opensimgear/device-template/hardware/README.md

# Mechanical hardware

## Development status and disclaimer

This project is heavily under development and is not ready for use. Use it entirely at your own risk. To the fullest extent permitted by applicable law, the authors and contributors disclaim all liability for any damage, loss, or other issues arising from its use.

No mechanical CAD or manufacturing-ready assembly is provided. Lite and Pro are reserved directories within this device repository. Mechanical implementation is tracked in the [GitHub project](https://github.com/orgs/opensimgear/projects/2).
