opensimgear/device-template/electronics/boards/starter/0.1.0/home-milling/review/wire-joins.csv

x_mm | y_mm | net | hole_mm | copper_land_mm | assembly
86.0 | 81.0 | GND | 0.8 | 1.8 | solder wire to both faces before bodies block access
89.2 | 92.0 | +3V3 | 0.8 | 1.8 | solder wire to both faces before bodies block access
91.0 | 97.54 | A0_RAW | 0.8 | 1.8 | solder wire to both faces before bodies block access
91.0 | 107.54 | A1_RAW | 0.8 | 1.8 | solder wire to both faces before bodies block access
91.0 | 117.54 | A2_RAW | 0.8 | 1.8 | solder wire to both faces before bodies block access
91.0 | 127.54 | A3_RAW | 0.8 | 1.8 | solder wire to both faces before bodies block access
91.0 | 137.54 | A4_RAW | 0.8 | 1.8 | solder wire to both faces before bodies block access
91.0 | 147.54 | A5_RAW | 0.8 | 1.8 | solder wire to both faces before bodies block access
91.0 | 157.54 | A6_RAW | 0.8 | 1.8 | solder wire to both faces before bodies block access
91.0 | 167.54 | A7_RAW | 0.8 | 1.8 | solder wire to both faces before bodies block access
97.9019 | 94.7684 | GND | 0.8 | 1.8 | solder wire to both faces before bodies block access
97.9019 | 104.7684 | GND | 0.8 | 1.8 | solder wire to both faces before bodies block access
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
