opensimgear/device-template/electronics/boards/starter/0.1.0/home-milling/coupon/review/back.png

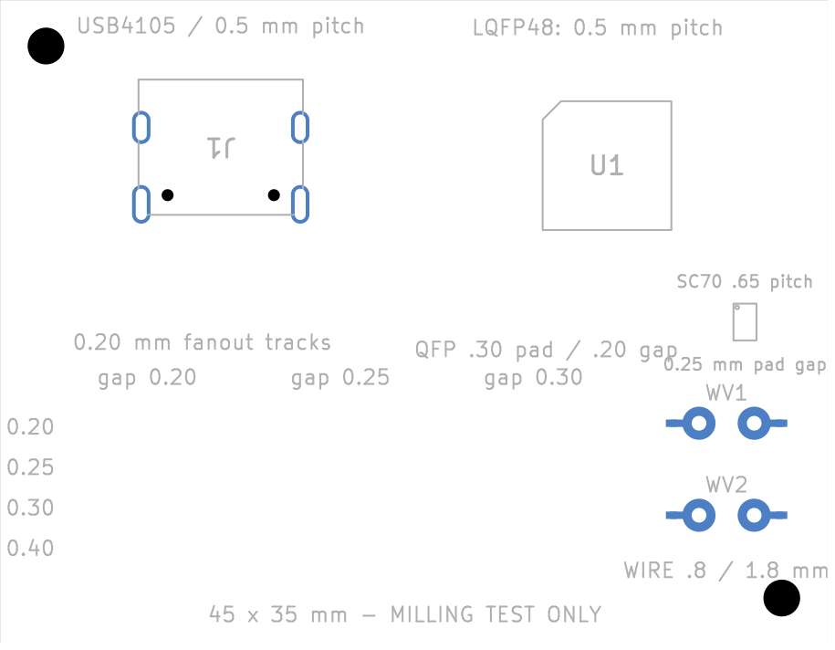
electronics/boards/starter/0.1.0/home-milling/coupon/review/back.png
