opensimgear/device-template/electronics/boards/starter/0.1.0/home-milling/coupon/review/front.png

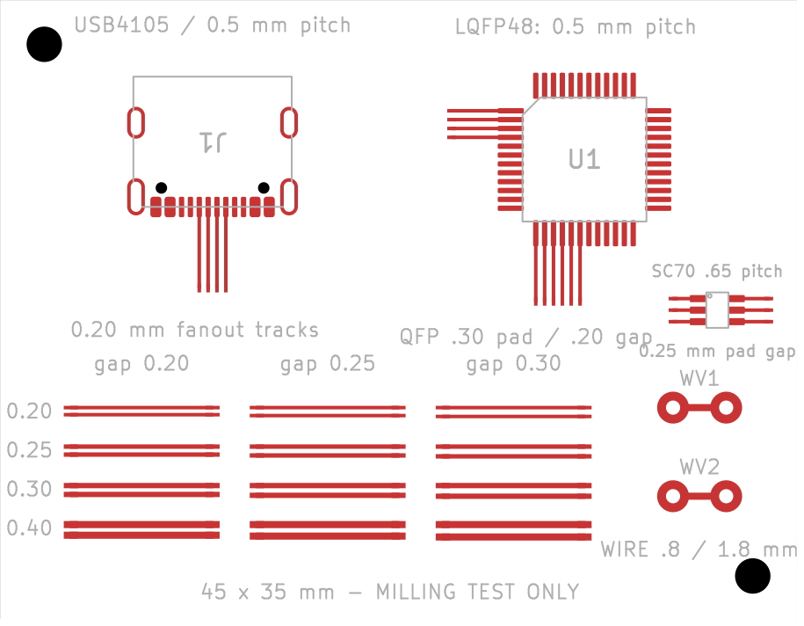
electronics/boards/starter/0.1.0/home-milling/coupon/review/front.png
