opensimgear/device-template/electronics/boards/starter/0.1.0/home-milling/review/back.png

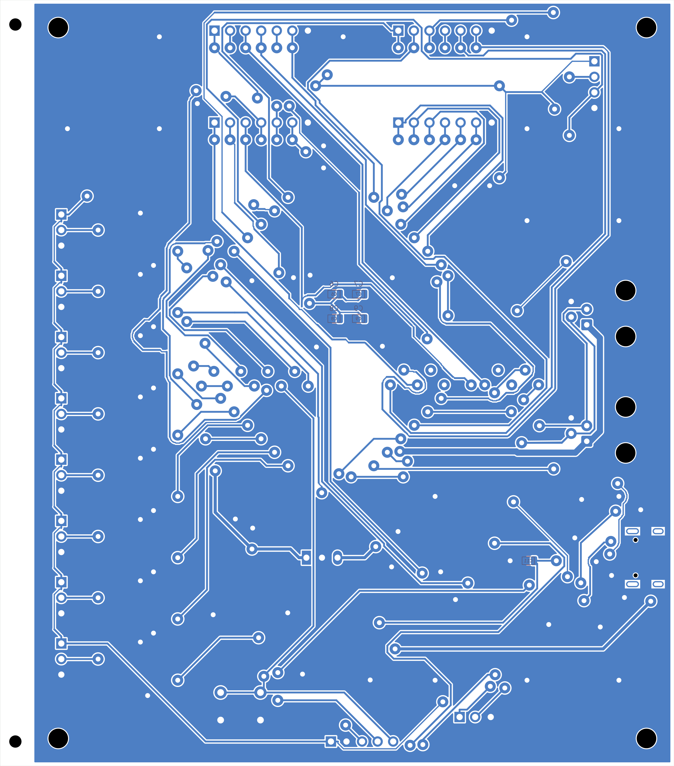
electronics/boards/starter/0.1.0/home-milling/review/back.png
