opensimgear/device-template/electronics/boards/starter/0.1.0/home-milling/review/front.png

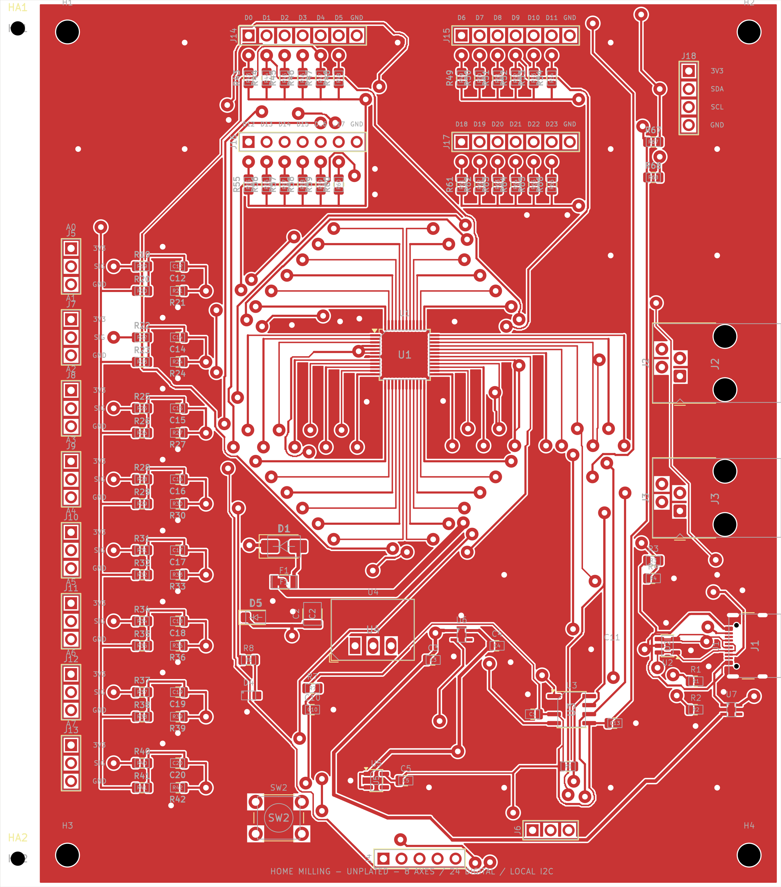
electronics/boards/starter/0.1.0/home-milling/review/front.png
