opensimgear/device-template/electronics/boards/starter/0.1.0/bom.csv

Reference | Value | Manufacturer part | Footprint | Datasheet
U1 | STM32G0B1CBT6 | STM32G0B1CBT6 | KiCad:LQFP-48_7x7mm_P0.5mm | https://www.st.com/resource/en/datasheet/stm32g0b1cb.pdf
J1 | USB-C DEVICE | USB4105-GF-A | KiCad:USB_C_Receptacle_GCT_USB4105-xx-A_16P_TopMnt_Horizontal | https://gct.co/files/drawings/usb4105.pdf
U2 | USBLC6-2SC6 | USBLC6-2SC6 | KiCad:SOT-23-6 | https://www.st.com/resource/en/datasheet/usblc6-2.pdf
R1 | 5.1k 1% | RC0805FR-075K1L | KiCad:R_0805_2012Metric | https://www.yageogroup.com/component-documentation/download/specsheet/RC0805FR-075K1L
R2 | 5.1k 1% | RC0805FR-075K1L | KiCad:R_0805_2012Metric | https://www.yageogroup.com/component-documentation/download/specsheet/RC0805FR-075K1L
R3 | 10k 1% | RC0805FR-0710KL | KiCad:R_0805_2012Metric | https://www.yageogroup.com/component-documentation/download/specsheet/RC0805FR-0710KL
R4 | 15k 1% | RC0805FR-0715KL | KiCad:R_0805_2012Metric | https://www.yageogroup.com/component-documentation/download/specsheet/RC0805FR-0715KL
U3 | TCAN3413D | TCAN3413D | KiCad:SOIC-8_3.9x4.9mm_P1.27mm | https://www.ti.com/lit/ds/symlink/tcan3413.pdf
J2 | 4P4C POWERED CAN | 5301-4P4C | OpenSimGear:RJ4P4C_Evercom_5301-4P4C_Horizontal | https://jlcpcb.com/partdetail/EVERCOM-53014P4C/C3097715
J3 | 4P4C POWERED CAN | 5301-4P4C | OpenSimGear:RJ4P4C_Evercom_5301-4P4C_Horizontal | https://jlcpcb.com/partdetail/EVERCOM-53014P4C/C3097715
R5 | 10k | RC0805FR-0710KL | KiCad:R_0805_2012Metric | https://www.yageogroup.com/component-documentation/download/specsheet/RC0805FR-0710KL
C1 | 100nF 25V X7R | C0805C104K3RACTU | KiCad:C_0805_2012Metric | https://content.kemet.com/datasheets/KEM_C1002_X7R_SMD.pdf
J6 | CAN TEST / END TERMINATION | TSW-103-07-L-S | OpenSimGear:PinHeader_Samtec_TSW-103-07-L-S_P2.54mm_Vertical | https://suddendocs.samtec.com/prints/tsw-xxx-xx-x-x-xx-xxx-footprint.pdf
F1 | 0.25A hold / 24V | 1206L025/24YR | OpenSimGear:Fuse_Littelfuse_1206L025-24YR | https://www.littelfuse.com/assetdocs/resettable-ptcs-1206l-datasheet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
D1 | SS14 | SS14-E3/61T | KiCad:D_SMA | https://www.vishay.com/docs/88746/ss12.pdf
U4 | R-78E5.0-0.5 | R-78E5.0-0.5 | KiCad:Converter_DCDC_RECOM_R-78E-0.5_THT | https://recom-power.com/pdf/Innoline/R-78E-0.5.pdf
U5 | TLV75533PDBVR | TLV75533PDBVR | KiCad:SOT-23-5 | https://www.ti.com/lit/ds/symlink/tlv755p.pdf
C2 | 10uF 50V X7R | GRM32ER71H106KA12L | KiCad:C_1210_3225Metric | https://search.murata.co.jp/Ceramy/image/img/A01X/G101/ENG/GRM32ER71H106KA12-04A.pdf
C3 | 1uF 25V X7R | C2012X7R1E105K125AB | KiCad:C_0805_2012Metric | https://product.tdk.com/en/search/capacitor/ceramic/mlcc/info?part_no=C2012X7R1E105K125AB
C4 | 1uF 25V X7R | C2012X7R1E105K125AB | KiCad:C_0805_2012Metric | https://product.tdk.com/en/search/capacitor/ceramic/mlcc/info?part_no=C2012X7R1E105K125AB
C5 | 2.2uF 25V X7R | C2012X7R1E225K125AB | KiCad:C_0805_2012Metric | https://product.tdk.com/en/search/capacitor/ceramic/mlcc/info?part_no=C2012X7R1E225K125AB
C6 | 100nF 25V X7R | C0805C104K3RACTU | KiCad:C_0805_2012Metric | https://content.kemet.com/datasheets/KEM_C1002_X7R_SMD.pdf
C7 | 1uF 25V X7R | C2012X7R1E105K125AB | KiCad:C_0805_2012Metric | https://product.tdk.com/en/search/capacitor/ceramic/mlcc/info?part_no=C2012X7R1E105K125AB
C8 | 100nF 25V X7R | C0805C104K3RACTU | KiCad:C_0805_2012Metric | https://content.kemet.com/datasheets/KEM_C1002_X7R_SMD.pdf
C9 | 100nF 25V X7R | C0805C104K3RACTU | KiCad:C_0805_2012Metric | https://content.kemet.com/datasheets/KEM_C1002_X7R_SMD.pdf
J4 | SWD / 3V3 REFERENCE ONLY | TSW-105-07-L-S | OpenSimGear:PinHeader_Samtec_TSW-105-07-L-S_P2.54mm_Vertical | https://suddendocs.samtec.com/prints/tsw-xxx-xx-x-x-xx-xxx-footprint.pdf
SW2 | RESET | B3F-1002-G | KiCad:SW_PUSH_6mm_H4.3mm | https://omronfs.omron.com/en_US/ecb/products/pdf/en-b3f.pdf
R7 | 10k | RC0805FR-0710KL | KiCad:R_0805_2012Metric | https://www.yageogroup.com/component-documentation/download/specsheet/RC0805FR-0710KL
C10 | 100nF 25V X7R | C0805C104K3RACTU | KiCad:C_0805_2012Metric | https://content.kemet.com/datasheets/KEM_C1002_X7R_SMD.pdf
R8 | 1k | RC0805FR-071KL | KiCad:R_0805_2012Metric | https://www.yageogroup.com/component-documentation/download/specsheet/RC0805FR-071KL
D4 | GREEN | AP2012SGC | OpenSimGear:LED_Kingbright_AP2012SGC_0805 | https://www.kingbrightusa.com/images/catalog/SPEC/AP2012SGC.pdf
C11 | 100nF 25V X7R | C0805C104K3RACTU | KiCad:C_0805_2012Metric | https://content.kemet.com/datasheets/KEM_C1002_X7R_SMD.pdf
U6 | LM66100DCKR | LM66100DCKR | OpenSimGear:TI_DCK0006A_SC70-6_LM66100 | https://www.ti.com/lit/ds/symlink/lm66100.pdf
U7 | LM66100DCKR | LM66100DCKR | OpenSimGear:TI_DCK0006A_SC70-6_LM66100 | https://www.ti.com/lit/ds/symlink/lm66100.pdf
D5 | SMF15A-E3-08 | SMF15A-E3-08 | KiCad:D_SMF | https://www.vishay.com/docs/85881/smf5v0atosmf58a.pdf
C13 | 100nF 25V X7R | C0805C104K3RACTU | KiCad:C_0805_2012Metric | https://content.kemet.com/datasheets/KEM_C1002_X7R_SMD.pdf
J5 | AXIS A0 / 3.3V | TSW-103-07-L-S | OpenSimGear:PinHeader_Samtec_TSW-103-07-L-S_P2.54mm_Vertical | https://suddendocs.samtec.com/prints/tsw-xxx-xx-x-x-xx-xxx-footprint.pdf
R19 | 1k | RC0805FR-071KL | KiCad:R_0805_2012Metric | https://www.yageogroup.com/component-documentation/download/specsheet/RC0805FR-071KL
R20 | 1M | RC0805FR-071ML | KiCad:R_0805_2012Metric | https://www.yageogroup.com/component-documentation/download/specsheet/RC0805FR-071ML
R21 | 1M | RC0805FR-071ML | KiCad:R_0805_2012Metric | https://www.yageogroup.com/component-documentation/download/specsheet/RC0805FR-071ML
C12 | 100nF 25V X7R | C0805C104K3RACTU | KiCad:C_0805_2012Metric | https://content.kemet.com/datasheets/KEM_C1002_X7R_SMD.pdf
J7 | AXIS A1 / 3.3V | TSW-103-07-L-S | OpenSimGear:PinHeader_Samtec_TSW-103-07-L-S_P2.54mm_Vertical | https://suddendocs.samtec.com/prints/tsw-xxx-xx-x-x-xx-xxx-footprint.pdf
R22 | 1k | RC0805FR-071KL | KiCad:R_0805_2012Metric | https://www.yageogroup.com/component-documentation/download/specsheet/RC0805FR-071KL
R23 | 1M | RC0805FR-071ML | KiCad:R_0805_2012Metric | https://www.yageogroup.com/component-documentation/download/specsheet/RC0805FR-071ML
R24 | 1M | RC0805FR-071ML | KiCad:R_0805_2012Metric | https://www.yageogroup.com/component-documentation/download/specsheet/RC0805FR-071ML
C14 | 100nF 25V X7R | C0805C104K3RACTU | KiCad:C_0805_2012Metric | https://content.kemet.com/datasheets/KEM_C1002_X7R_SMD.pdf
J8 | AXIS A2 / 3.3V | TSW-103-07-L-S | OpenSimGear:PinHeader_Samtec_TSW-103-07-L-S_P2.54mm_Vertical | https://suddendocs.samtec.com/prints/tsw-xxx-xx-x-x-xx-xxx-footprint.pdf
R25 | 1k | RC0805FR-071KL | KiCad:R_0805_2012Metric | https://www.yageogroup.com/component-documentation/download/specsheet/RC0805FR-071KL
R26 | 1M | RC0805FR-071ML | KiCad:R_0805_2012Metric | https://www.yageogroup.com/component-documentation/download/specsheet/RC0805FR-071ML
R27 | 1M | RC0805FR-071ML | KiCad:R_0805_2012Metric | https://www.yageogroup.com/component-documentation/download/specsheet/RC0805FR-071ML
C15 | 100nF 25V X7R | C0805C104K3RACTU | KiCad:C_0805_2012Metric | https://content.kemet.com/datasheets/KEM_C1002_X7R_SMD.pdf
J9 | AXIS A3 / 3.3V | TSW-103-07-L-S | OpenSimGear:PinHeader_Samtec_TSW-103-07-L-S_P2.54mm_Vertical | https://suddendocs.samtec.com/prints/tsw-xxx-xx-x-x-xx-xxx-footprint.pdf
R28 | 1k | RC0805FR-071KL | KiCad:R_0805_2012Metric | https://www.yageogroup.com/component-documentation/download/specsheet/RC0805FR-071KL
R29 | 1M | RC0805FR-071ML | KiCad:R_0805_2012Metric | https://www.yageogroup.com/component-documentation/download/specsheet/RC0805FR-071ML
R30 | 1M | RC0805FR-071ML | KiCad:R_0805_2012Metric | https://www.yageogroup.com/component-documentation/download/specsheet/RC0805FR-071ML
C16 | 100nF 25V X7R | C0805C104K3RACTU | KiCad:C_0805_2012Metric | https://content.kemet.com/datasheets/KEM_C1002_X7R_SMD.pdf
J10 | AXIS A4 / 3.3V | TSW-103-07-L-S | OpenSimGear:PinHeader_Samtec_TSW-103-07-L-S_P2.54mm_Vertical | https://suddendocs.samtec.com/prints/tsw-xxx-xx-x-x-xx-xxx-footprint.pdf
R31 | 1k | RC0805FR-071KL | KiCad:R_0805_2012Metric | https://www.yageogroup.com/component-documentation/download/specsheet/RC0805FR-071KL
R32 | 1M | RC0805FR-071ML | KiCad:R_0805_2012Metric | https://www.yageogroup.com/component-documentation/download/specsheet/RC0805FR-071ML
R33 | 1M | RC0805FR-071ML | KiCad:R_0805_2012Metric | https://www.yageogroup.com/component-documentation/download/specsheet/RC0805FR-071ML
C17 | 100nF 25V X7R | C0805C104K3RACTU | KiCad:C_0805_2012Metric | https://content.kemet.com/datasheets/KEM_C1002_X7R_SMD.pdf
J11 | AXIS A5 / 3.3V | TSW-103-07-L-S | OpenSimGear:PinHeader_Samtec_TSW-103-07-L-S_P2.54mm_Vertical | https://suddendocs.samtec.com/prints/tsw-xxx-xx-x-x-xx-xxx-footprint.pdf
R34 | 1k | RC0805FR-071KL | KiCad:R_0805_2012Metric | https://www.yageogroup.com/component-documentation/download/specsheet/RC0805FR-071KL
R35 | 1M | RC0805FR-071ML | KiCad:R_0805_2012Metric | https://www.yageogroup.com/component-documentation/download/specsheet/RC0805FR-071ML
R36 | 1M | RC0805FR-071ML | KiCad:R_0805_2012Metric | https://www.yageogroup.com/component-documentation/download/specsheet/RC0805FR-071ML
C18 | 100nF 25V X7R | C0805C104K3RACTU | KiCad:C_0805_2012Metric | https://content.kemet.com/datasheets/KEM_C1002_X7R_SMD.pdf
J12 | AXIS A6 / 3.3V | TSW-103-07-L-S | OpenSimGear:PinHeader_Samtec_TSW-103-07-L-S_P2.54mm_Vertical | https://suddendocs.samtec.com/prints/tsw-xxx-xx-x-x-xx-xxx-footprint.pdf
R37 | 1k | RC0805FR-071KL | KiCad:R_0805_2012Metric | https://www.yageogroup.com/component-documentation/download/specsheet/RC0805FR-071KL
R38 | 1M | RC0805FR-071ML | KiCad:R_0805_2012Metric | https://www.yageogroup.com/component-documentation/download/specsheet/RC0805FR-071ML
R39 | 1M | RC0805FR-071ML | KiCad:R_0805_2012Metric | https://www.yageogroup.com/component-documentation/download/specsheet/RC0805FR-071ML
C19 | 100nF 25V X7R | C0805C104K3RACTU | KiCad:C_0805_2012Metric | https://content.kemet.com/datasheets/KEM_C1002_X7R_SMD.pdf
J13 | AXIS A7 / 3.3V | TSW-103-07-L-S | OpenSimGear:PinHeader_Samtec_TSW-103-07-L-S_P2.54mm_Vertical | https://suddendocs.samtec.com/prints/tsw-xxx-xx-x-x-xx-xxx-footprint.pdf
R40 | 1k | RC0805FR-071KL | KiCad:R_0805_2012Metric | https://www.yageogroup.com/component-documentation/download/specsheet/RC0805FR-071KL
R41 | 1M | RC0805FR-071ML | KiCad:R_0805_2012Metric | https://www.yageogroup.com/component-documentation/download/specsheet/RC0805FR-071ML
R42 | 1M | RC0805FR-071ML | KiCad:R_0805_2012Metric | https://www.yageogroup.com/component-documentation/download/specsheet/RC0805FR-071ML
C20 | 100nF 25V X7R | C0805C104K3RACTU | KiCad:C_0805_2012Metric | https://content.kemet.com/datasheets/KEM_C1002_X7R_SMD.pdf
J14 | DIGITAL D0–D5 | TSW-107-07-L-S | OpenSimGear:PinHeader_Samtec_TSW-107-07-L-S_P2.54mm_Vertical | https://suddendocs.samtec.com/prints/tsw-xxx-xx-x-x-xx-xxx-footprint.pdf
R43 | 10k | RC0805FR-0710KL | KiCad:R_0805_2012Metric | https://www.yageogroup.com/component-documentation/download/specsheet/RC0805FR-0710KL
R44 | 10k | RC0805FR-0710KL | KiCad:R_0805_2012Metric | https://www.yageogroup.com/component-documentation/download/specsheet/RC0805FR-0710KL
R45 | 10k | RC0805FR-0710KL | KiCad:R_0805_2012Metric | https://www.yageogroup.com/component-documentation/download/specsheet/RC0805FR-0710KL
R46 | 10k | RC0805FR-0710KL | KiCad:R_0805_2012Metric | https://www.yageogroup.com/component-documentation/download/specsheet/RC0805FR-0710KL
R47 | 10k | RC0805FR-0710KL | KiCad:R_0805_2012Metric | https://www.yageogroup.com/component-documentation/download/specsheet/RC0805FR-0710KL
R48 | 10k | RC0805FR-0710KL | KiCad:R_0805_2012Metric | https://www.yageogroup.com/component-documentation/download/specsheet/RC0805FR-0710KL
J15 | DIGITAL D6–D11 | TSW-107-07-L-S | OpenSimGear:PinHeader_Samtec_TSW-107-07-L-S_P2.54mm_Vertical | https://suddendocs.samtec.com/prints/tsw-xxx-xx-x-x-xx-xxx-footprint.pdf
R49 | 10k | RC0805FR-0710KL | KiCad:R_0805_2012Metric | https://www.yageogroup.com/component-documentation/download/specsheet/RC0805FR-0710KL
R50 | 10k | RC0805FR-0710KL | KiCad:R_0805_2012Metric | https://www.yageogroup.com/component-documentation/download/specsheet/RC0805FR-0710KL
R51 | 10k | RC0805FR-0710KL | KiCad:R_0805_2012Metric | https://www.yageogroup.com/component-documentation/download/specsheet/RC0805FR-0710KL
R52 | 10k | RC0805FR-0710KL | KiCad:R_0805_2012Metric | https://www.yageogroup.com/component-documentation/download/specsheet/RC0805FR-0710KL
R53 | 10k | RC0805FR-0710KL | KiCad:R_0805_2012Metric | https://www.yageogroup.com/component-documentation/download/specsheet/RC0805FR-0710KL
R54 | 10k | RC0805FR-0710KL | KiCad:R_0805_2012Metric | https://www.yageogroup.com/component-documentation/download/specsheet/RC0805FR-0710KL
J16 | DIGITAL D12–D17 | TSW-107-07-L-S | OpenSimGear:PinHeader_Samtec_TSW-107-07-L-S_P2.54mm_Vertical | https://suddendocs.samtec.com/prints/tsw-xxx-xx-x-x-xx-xxx-footprint.pdf
R55 | 10k | RC0805FR-0710KL | KiCad:R_0805_2012Metric | https://www.yageogroup.com/component-documentation/download/specsheet/RC0805FR-0710KL
R56 | 10k | RC0805FR-0710KL | KiCad:R_0805_2012Metric | https://www.yageogroup.com/component-documentation/download/specsheet/RC0805FR-0710KL
R57 | 10k | RC0805FR-0710KL | KiCad:R_0805_2012Metric | https://www.yageogroup.com/component-documentation/download/specsheet/RC0805FR-0710KL
R58 | 10k | RC0805FR-0710KL | KiCad:R_0805_2012Metric | https://www.yageogroup.com/component-documentation/download/specsheet/RC0805FR-0710KL
R59 | 10k | RC0805FR-0710KL | KiCad:R_0805_2012Metric | https://www.yageogroup.com/component-documentation/download/specsheet/RC0805FR-0710KL
R60 | 10k | RC0805FR-0710KL | KiCad:R_0805_2012Metric | https://www.yageogroup.com/component-documentation/download/specsheet/RC0805FR-0710KL
J17 | DIGITAL D18–D23 | TSW-107-07-L-S | OpenSimGear:PinHeader_Samtec_TSW-107-07-L-S_P2.54mm_Vertical | https://suddendocs.samtec.com/prints/tsw-xxx-xx-x-x-xx-xxx-footprint.pdf
R61 | 10k | RC0805FR-0710KL | KiCad:R_0805_2012Metric | https://www.yageogroup.com/component-documentation/download/specsheet/RC0805FR-0710KL
R62 | 10k | RC0805FR-0710KL | KiCad:R_0805_2012Metric | https://www.yageogroup.com/component-documentation/download/specsheet/RC0805FR-0710KL
R63 | 10k | RC0805FR-0710KL | KiCad:R_0805_2012Metric | https://www.yageogroup.com/component-documentation/download/specsheet/RC0805FR-0710KL
R64 | 10k | RC0805FR-0710KL | KiCad:R_0805_2012Metric | https://www.yageogroup.com/component-documentation/download/specsheet/RC0805FR-0710KL
R65 | 10k | RC0805FR-0710KL | KiCad:R_0805_2012Metric | https://www.yageogroup.com/component-documentation/download/specsheet/RC0805FR-0710KL
R66 | 10k | RC0805FR-0710KL | KiCad:R_0805_2012Metric | https://www.yageogroup.com/component-documentation/download/specsheet/RC0805FR-0710KL
J18 | LOCAL 3.3V I2C EXPANSION | TSW-104-07-L-S | OpenSimGear:PinHeader_Samtec_TSW-104-07-L-S_P2.54mm_Vertical | https://suddendocs.samtec.com/prints/tsw-xxx-xx-x-x-xx-xxx-footprint.pdf
R67 | 4.7k | RC0805FR-074K7L | KiCad:R_0805_2012Metric | https://www.yageogroup.com/component-documentation/download/specsheet/RC0805FR-074K7L
R68 | 4.7k | RC0805FR-074K7L | KiCad:R_0805_2012Metric | https://www.yageogroup.com/component-documentation/download/specsheet/RC0805FR-074K7L
