opensimgear/device-template/electronics/boards/starter/0.1.0/review/routing.pdf

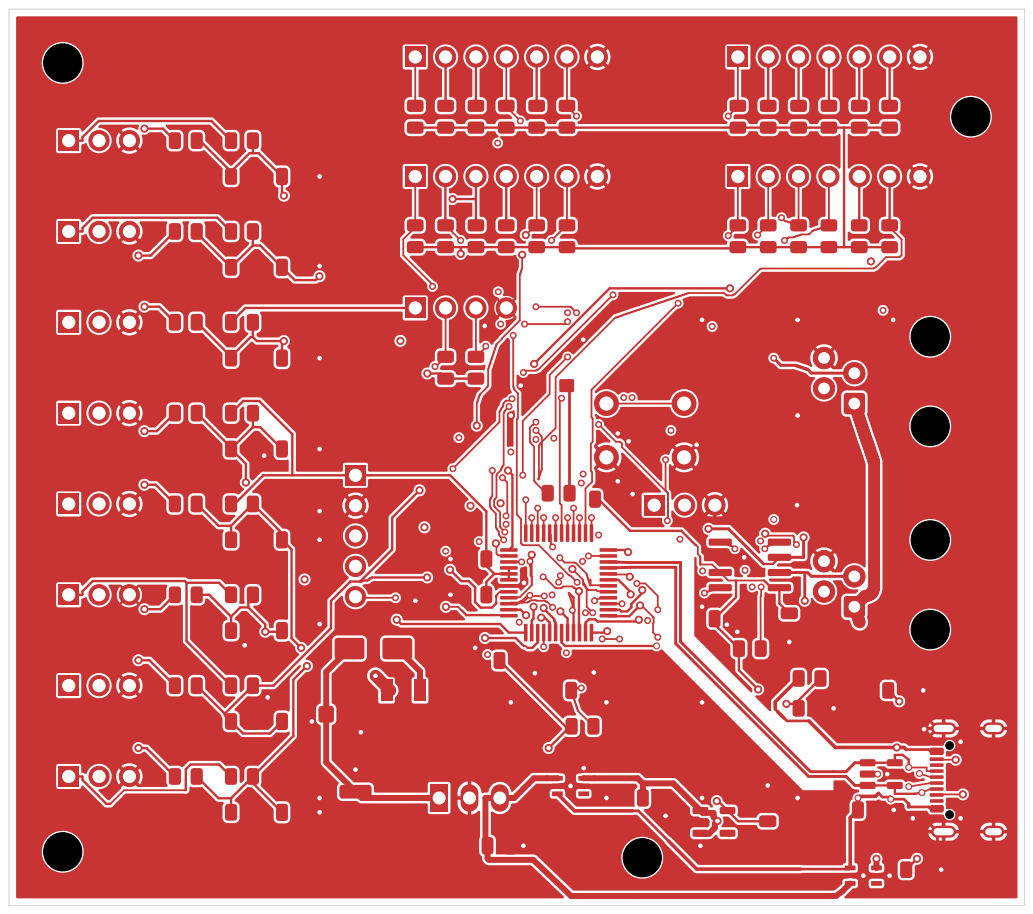
[picture p5: page 1]

OpenSimGear
Sheet:
File: starter.kicad_pcb
Title: OpenSimGear generic STM32G0B1 module

Size: A4 | Rev: 0.1.0
KiCad E.D.A. 10.0.6 | Id: 1/4

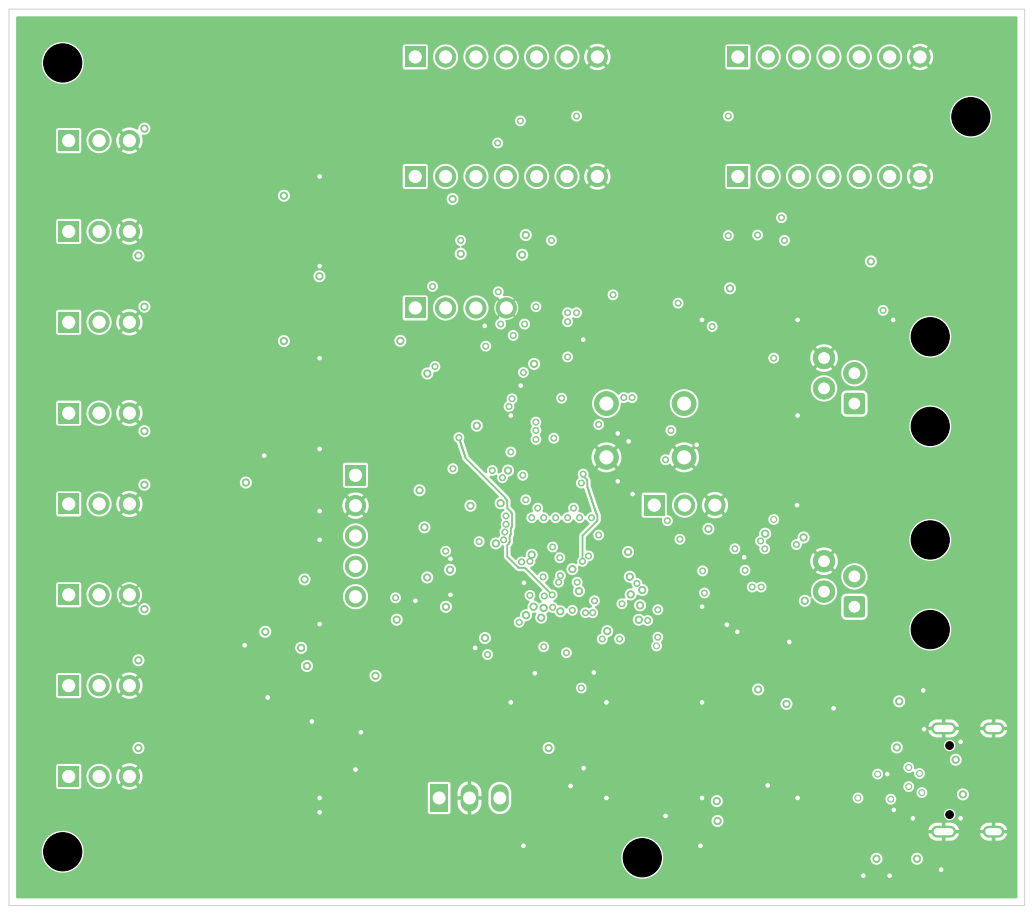
[picture p6: page 2]

OpenSimGear
Sheet:
File: starter.kicad_pcb
Title: OpenSimGear generic STM32G0B1 module

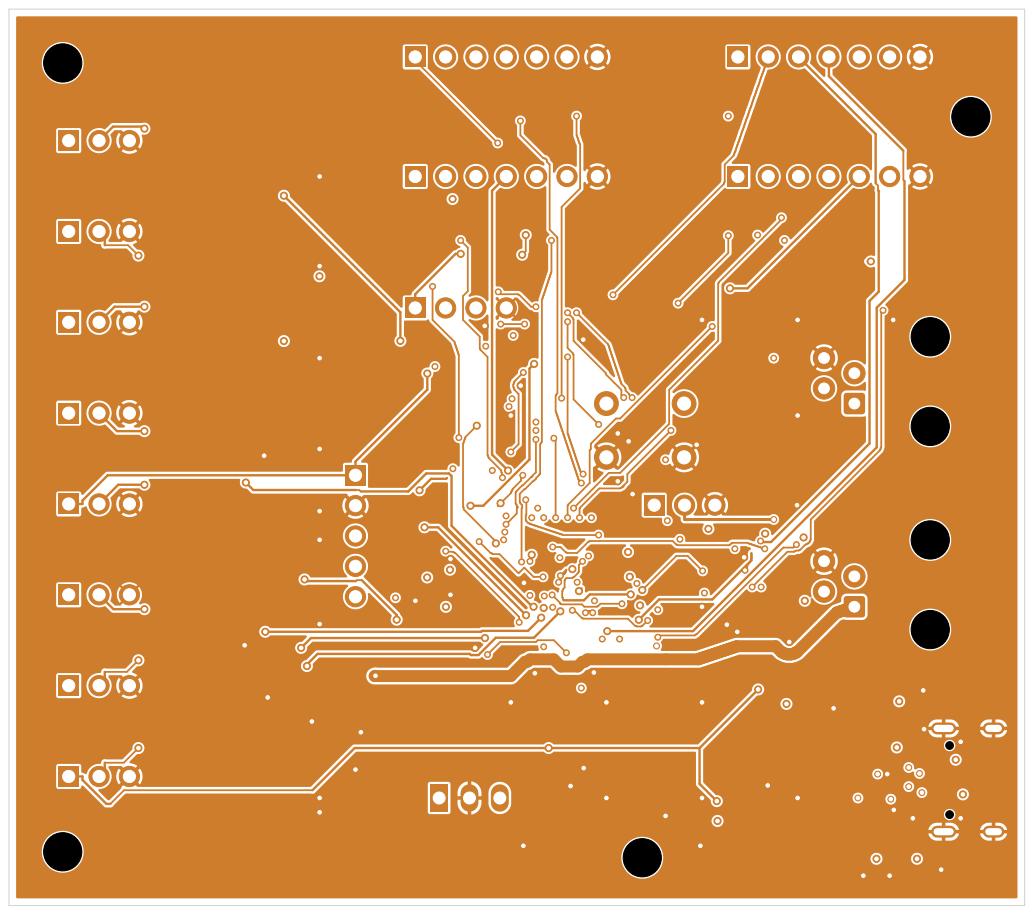
[picture p7: page 3]

OpenSimGear
Sheet:
File: starter.kicad_pcb
Title: OpenSimGear generic STM32G0B1 module

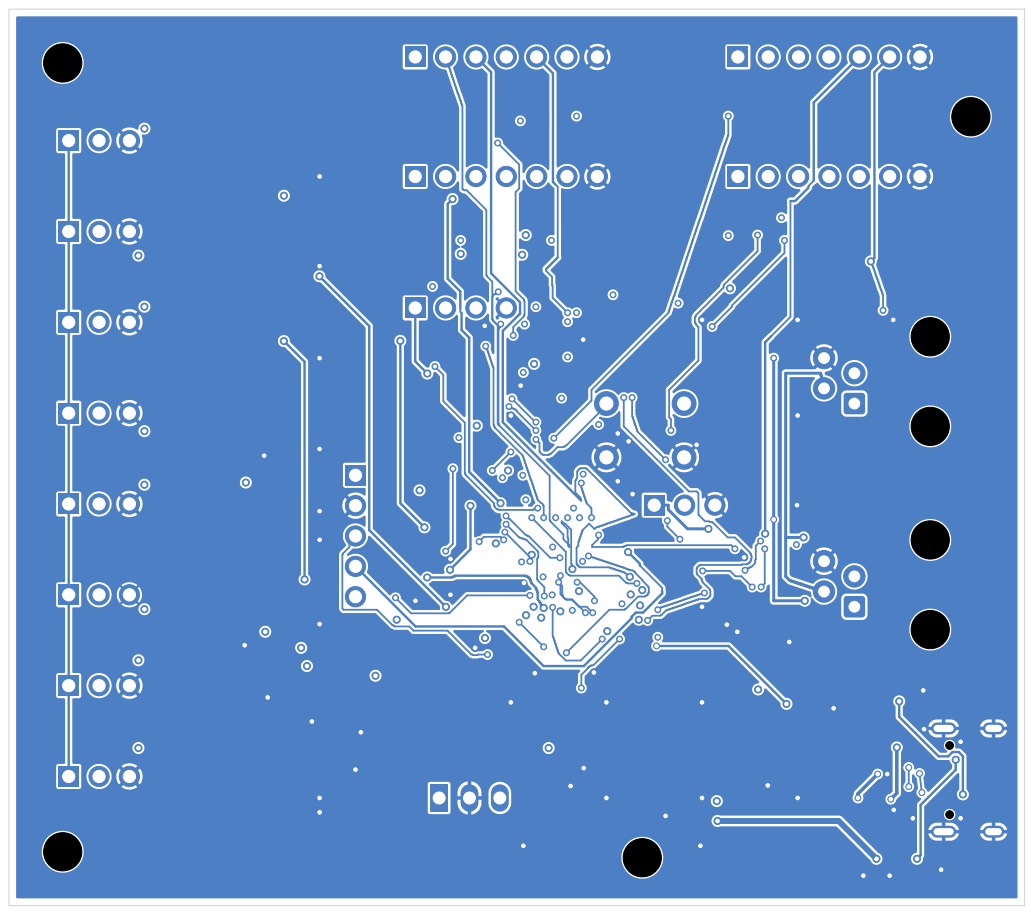
[picture p8: page 4]

OpenSimGear
Sheet:
File: starter.kicad_pcb
Title: OpenSimGear generic STM32G0B1 module
