opensimgear/device-template/electronics/boards/starter/0.1.0/review/schematic.pdf

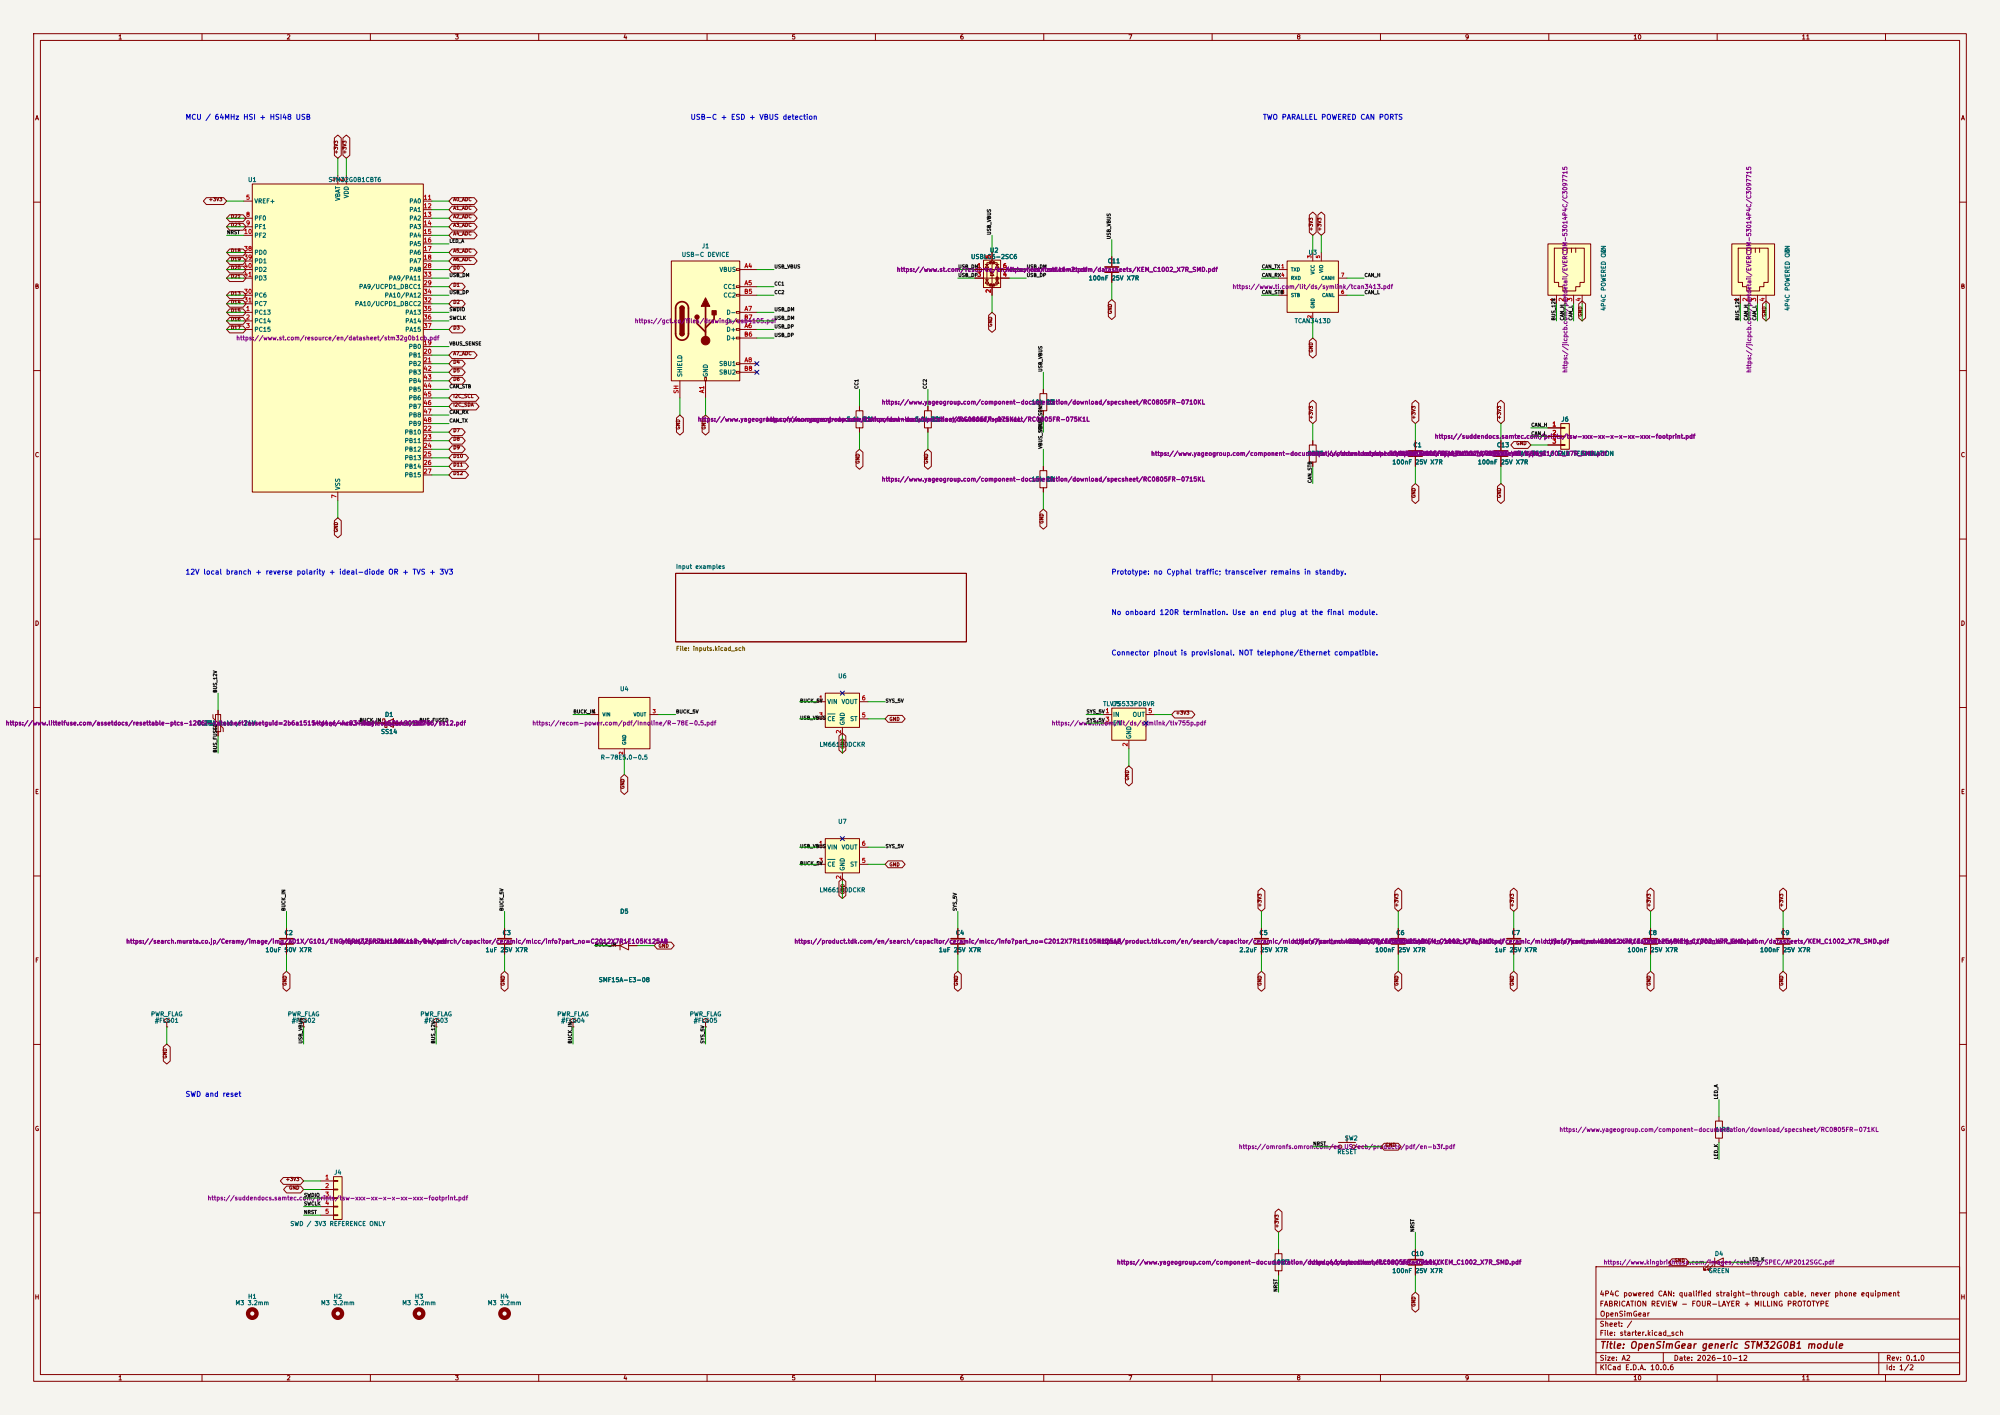
[picture p9: page 1]

USB-C + ESD + VBUS detection

4 J2 4P4C POWERED CAN https://jlcpcb.com/partdetail/EVERCOM-53014P4C/C3097715

4 J3 4P4C POWERED CAN https://jlcpcb.com/partdetail/EVERCOM-53014P4C/C3097715

https://content.kemet.com/datasheets/KEM_C1002_X7R_SMD.pdf

https://www.st.com/resource/en/datasheet/usblc6-2.pdf 1
https://www.st.com/resource/en/datasheet/usblc6-2.pdf

https://www.ti.com/lit/ds/symlink/tcan3413.pdf

https://gct.co/files/drawings/usb4105.pdf

https://suddendocs.samtec.com/prints/tsw-xxx-xx-x-x-xx-xxx-footprint.pdf GND A1

https://www.yageogroup.com/component-documentation/download/specsheet/RC0805FR-075K1L 5.1k R11%

https://www.yageogroup.com/component-documentation/download/specsheet/RC0805FR-075K1L 5.1k R21%

https://content.kemet.com/datasheets/KEM_C1002_X7R_SMD.pdf Local TCAN3413 VIO bypass 1

https://suddendocs.samtec.com/prints/tsw-xxx-xx-x-x-xx-xxx-footprint.pdf 1

J6 CAN TEST / END TERMINATION

https://www.yageogroup.com/component-documentation/download/specsheet/RC0805FR-0710KL 10kR5

https://content.kemet.com/datasheets/KEM_C1002_X7R_SMD.pdf Local TCAN3413 VCC bypass

https://content.kemet.com/datasheets/KEM_C1002_X7R_SMD.pdf Local TCAN3413 VIO bypass

Input examples File: inputs.kicad_sch

12V local branch + reverse polarity + ideal-diode OR + TVS + 3V3

Prototype: no Cyphal traffic; transceiver remains in standby.

No onboard 120R termination. Use an end plug at the final module.

Connector pinout is provisional. NOT telephone/Ethernet compatible.

https://www.vishay.com/docs/88746/ss12.pdf

https://recom-power.com/pdf/Innoline/R-78E-0.5.pdf

https://www.ti.com/lit/ds/symlink/tlv755p.pdf C4

https://search.murata.co.jp/Ceramy/image/img/A01X/G101/ENG/GRM32ER71H106KA12-04A.pdf

https://content.kemet.com/datasheets/KEM_C1002_X7R_SMD.pdf C6

https://content.kemet.com/datasheets/KEM_C1002_X7R_SMD.pdf C8

https://product.tdk.com/en/search/capacitor/ceramic/mlcc/info?part_no=C2012X7R1E105K125AB

https://product.tdk.com/en/search/capacitor/ceramic/mlcc/info?part_no=C2012X7R1E225K125AB

SW2 RESET https://omronfs.omron.com/en_US/ecb/products/pdf/en-b3f.pdf C10

https://www.yageogroup.com/component-documentation/download/specsheet/RC0805FR-071KL 1kR8

SWD / 3V3 REFERENCE ONLY https://suddendocs.samtec.com/prints/tsw-xxx-xx-x-x-xx-xxx-footprint.pdf H1 M3 3.2mm

https://www.yageogroup.com/component-documentation/download/specsheet/RC0805FR-0710KL 10kR7

https://www.kingbrightusa.com/images/catalog/SPEC/AP2012SGC.pdf

4P4C powered CAN: qualified straight-through cable, never phone equipment
FABRICATION REVIEW - FOUR-LAYER + MILLING PROTOTYPE
OpenSimGear
Sheet: /
File: starter.kicad_sch
Title: OpenSimGear generic STM32G0B1 module

Size: A2 | Rev: 0.1.0
KiCad E.D.A. 10.0.6 | Id: 1/2

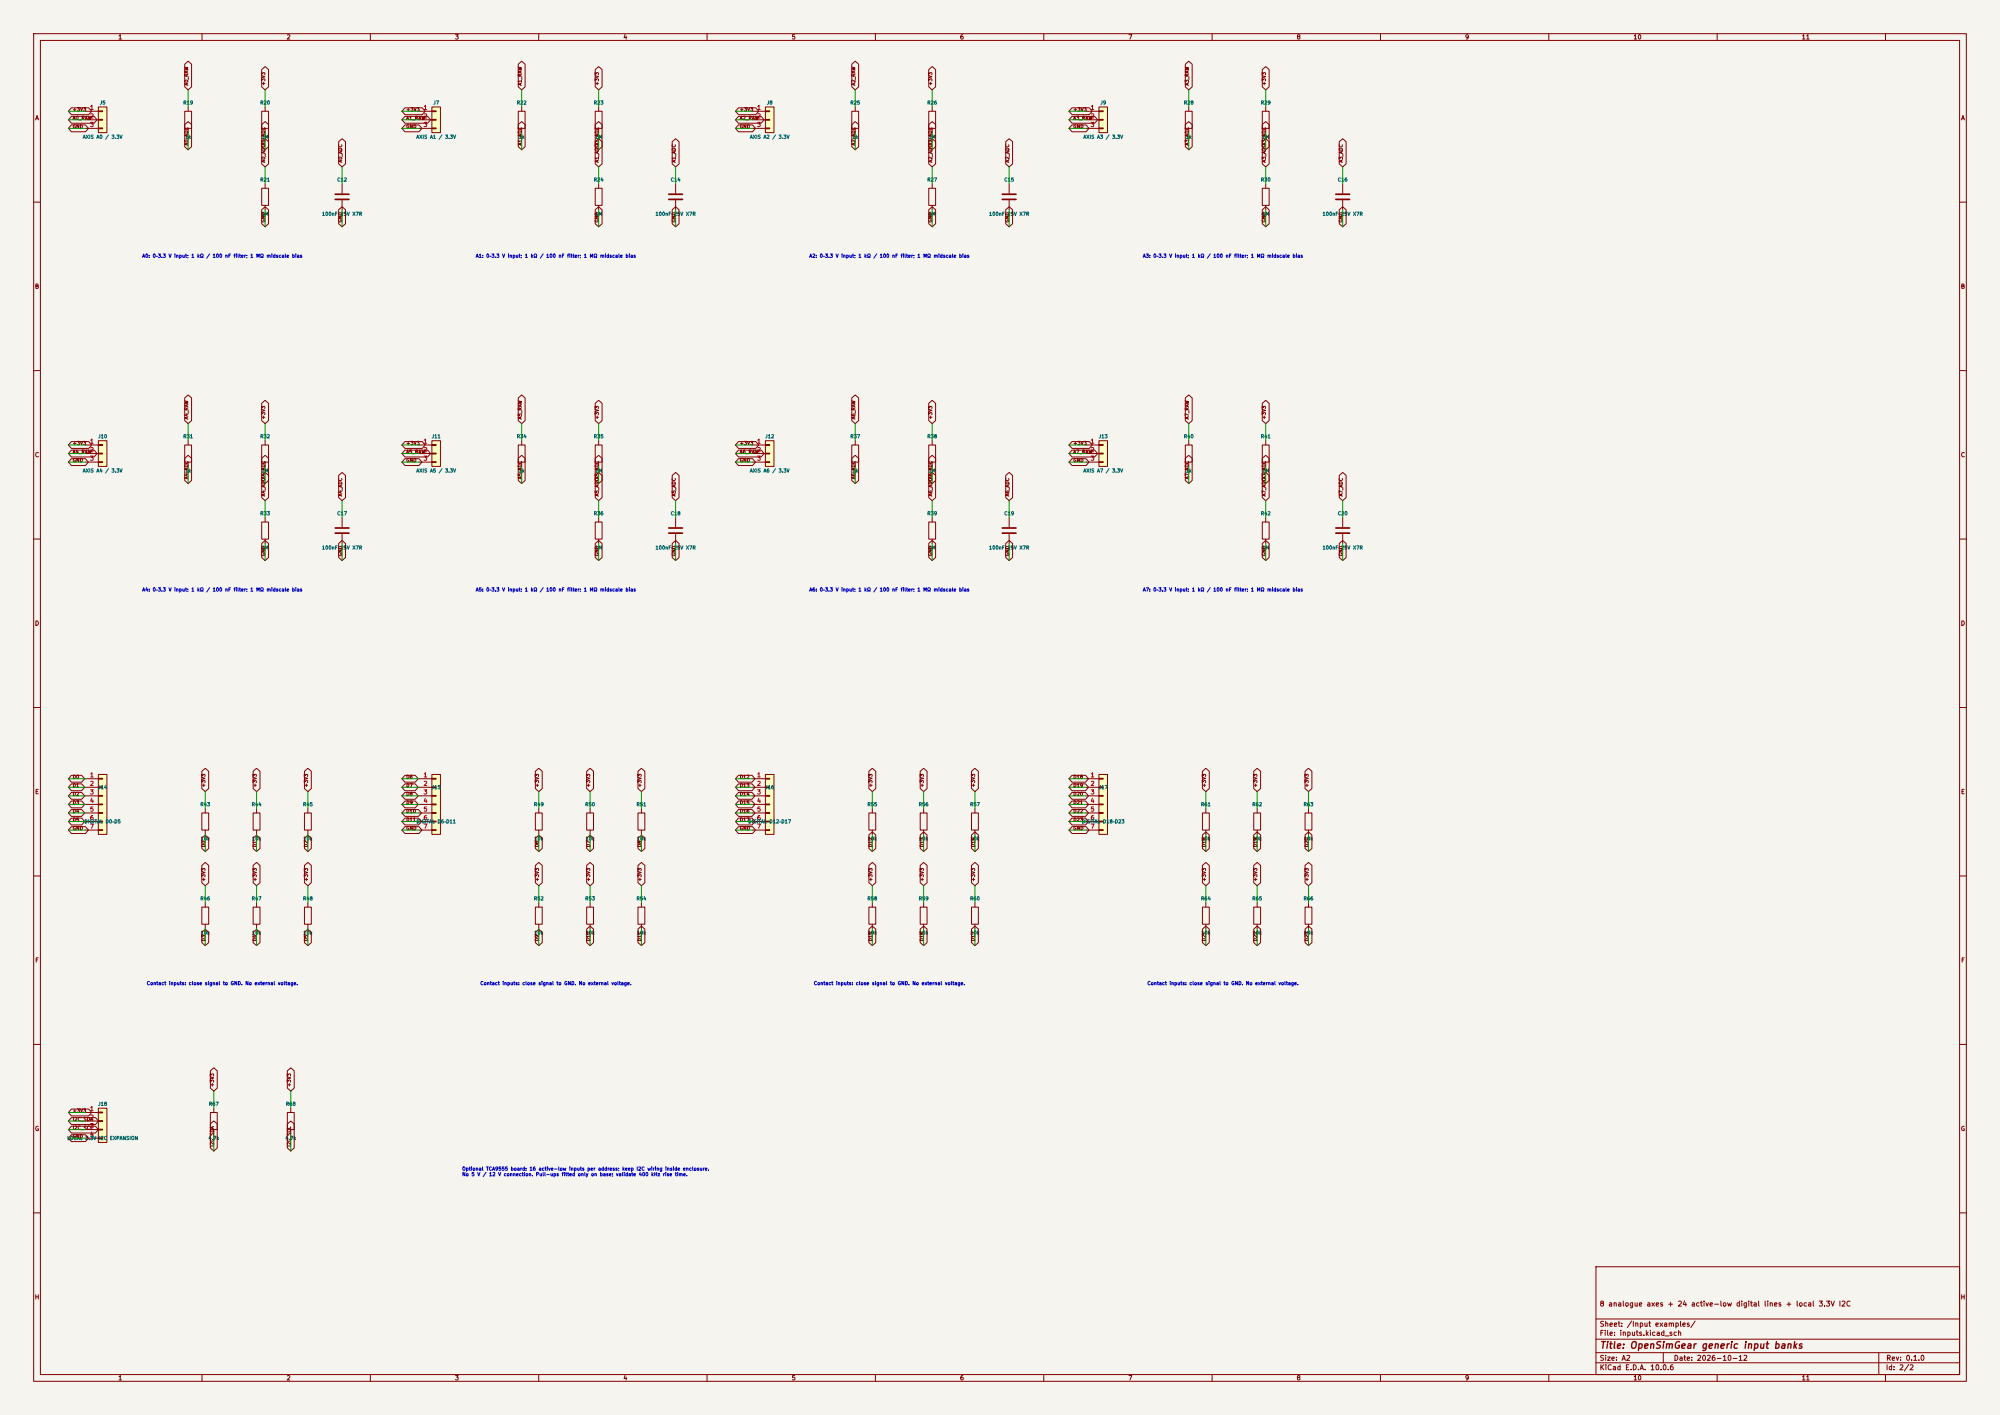
[picture p10: page 2]

A0: 0–3.3 V input; 1 kΩ / 100 nF filter; 1 MΩ midscale bias

A1: 0–3.3 V input; 1 kΩ / 100 nF filter; 1 MΩ midscale bias

A2: 0–3.3 V input; 1 kΩ / 100 nF filter; 1 MΩ midscale bias

A3: 0–3.3 V input; 1 kΩ / 100 nF filter; 1 MΩ midscale bias

A4: 0–3.3 V input; 1 kΩ / 100 nF filter; 1 MΩ midscale bias

A5: 0–3.3 V input; 1 kΩ / 100 nF filter; 1 MΩ midscale bias

A6: 0–3.3 V input; 1 kΩ / 100 nF filter; 1 MΩ midscale bias

A7: 0–3.3 V input; 1 kΩ / 100 nF filter; 1 MΩ midscale bias

Contact inputs: close signal to GND. No external voltage.

8 analogue axes + 24 active-low digital lines + local 3.3V I2C

Sheet: /Input examples/
File: inputs.kicad_sch
Title: OpenSimGear generic input banks

Size: A2 | Rev: 0.1.0
KiCad E.D.A. 10.0.6 | Id: 2/2
