opensimgear/device-template/electronics/boards/starter/0.1.0/home-milling/review/routing.pdf

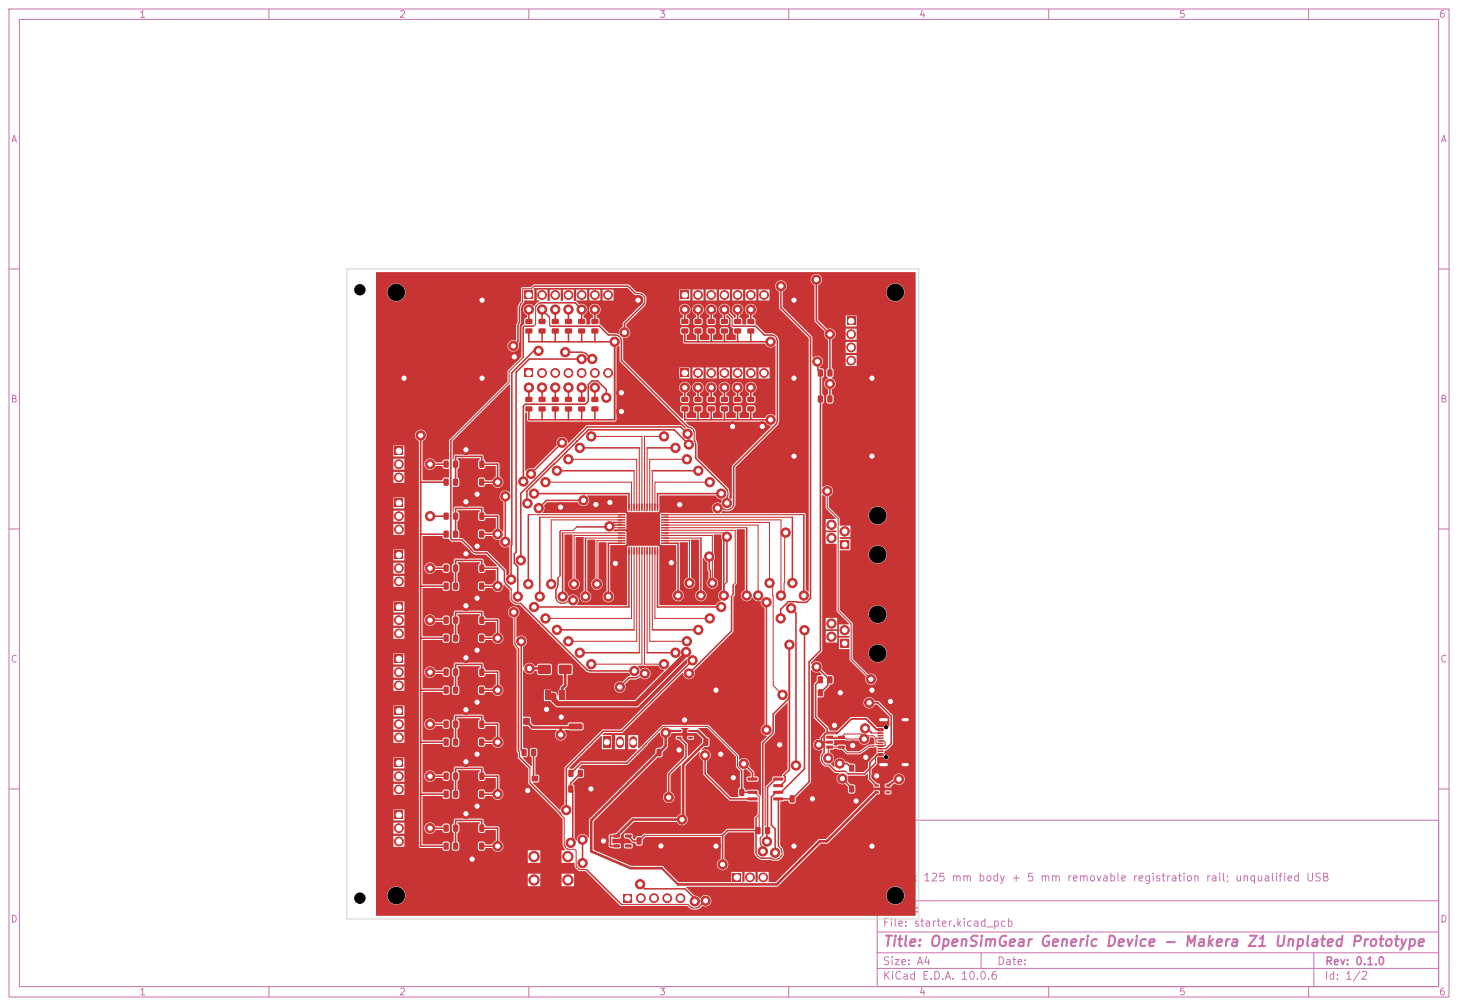
[picture p11: page 1]

105 x | 125 mm body + 5 mm removable registration rail; unqualified USB

Sheet: File: starter.kicad_pcb | | D Date:

Title: OpenSimGear Generic Device - Makera Z1 Unplated Prototype

Size: A4 | Rev: 0.1.0
KiCad E.D.A. 10.0.6 | Id: 1/2

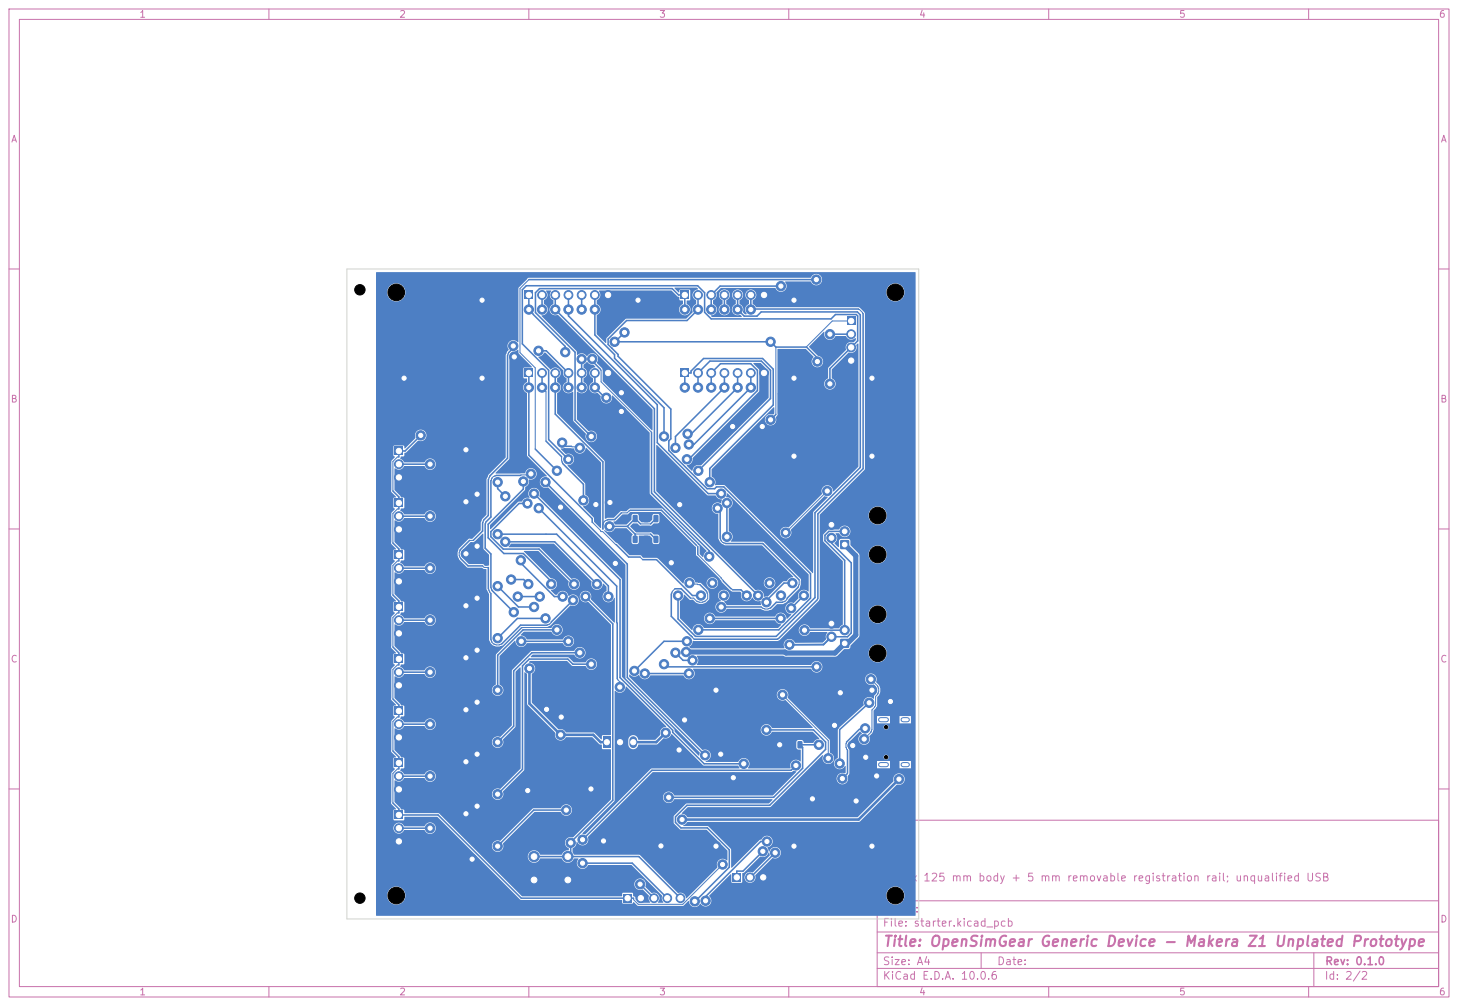
[picture p12: page 2]

105 x | 125 mm body + 5 mm removable registration rail; unqualified USB

Sheet: File: starter.kicad_pcb | | D Date:

Title: OpenSimGear Generic Device - Makera Z1 Unplated Prototype

Size: A4 | Rev: 0.1.0
KiCad E.D.A. 10.0.6 | Id: 2/2
