opensimgear/device-template/electronics/boards/starter/0.1.0/home-milling/coupon/review/coupon.pdf

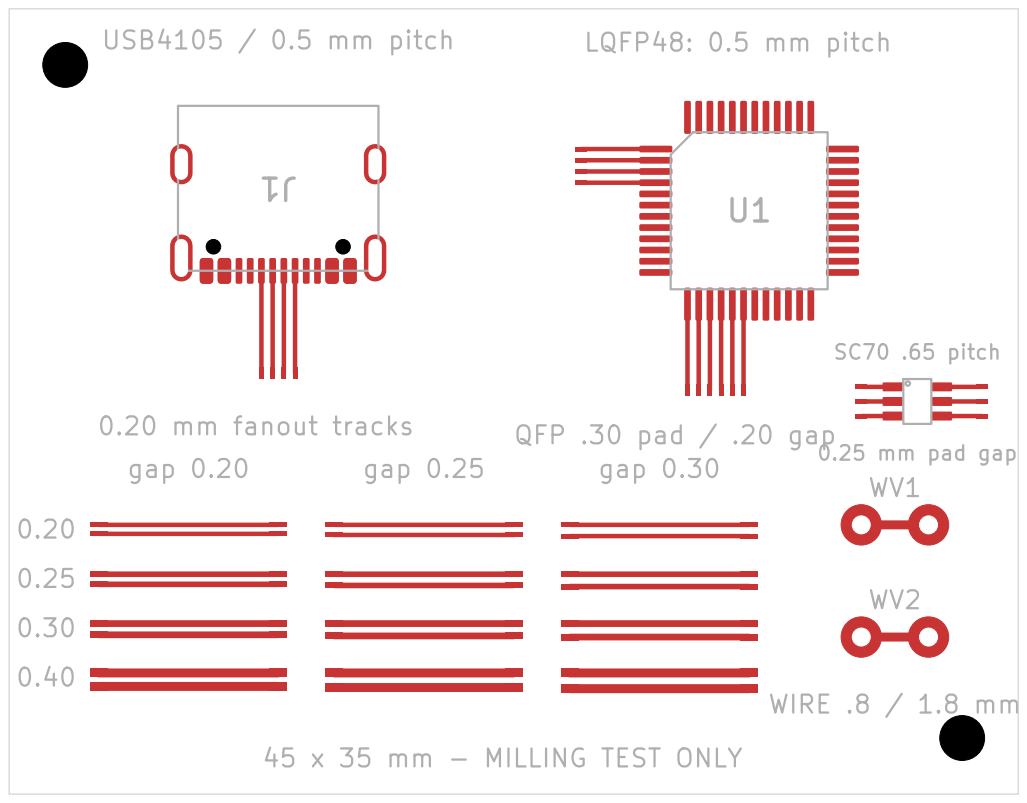
[picture p13: page 1]

0.20 mm fanout tracks USB4105 / 0.5 mm pitch

SC70 .65 pitch 0.25 mm pad gap 0.20

45 x 35 mm - MILLING TEST ONLY gap 0.30 QFP .30 pad / .20 gap

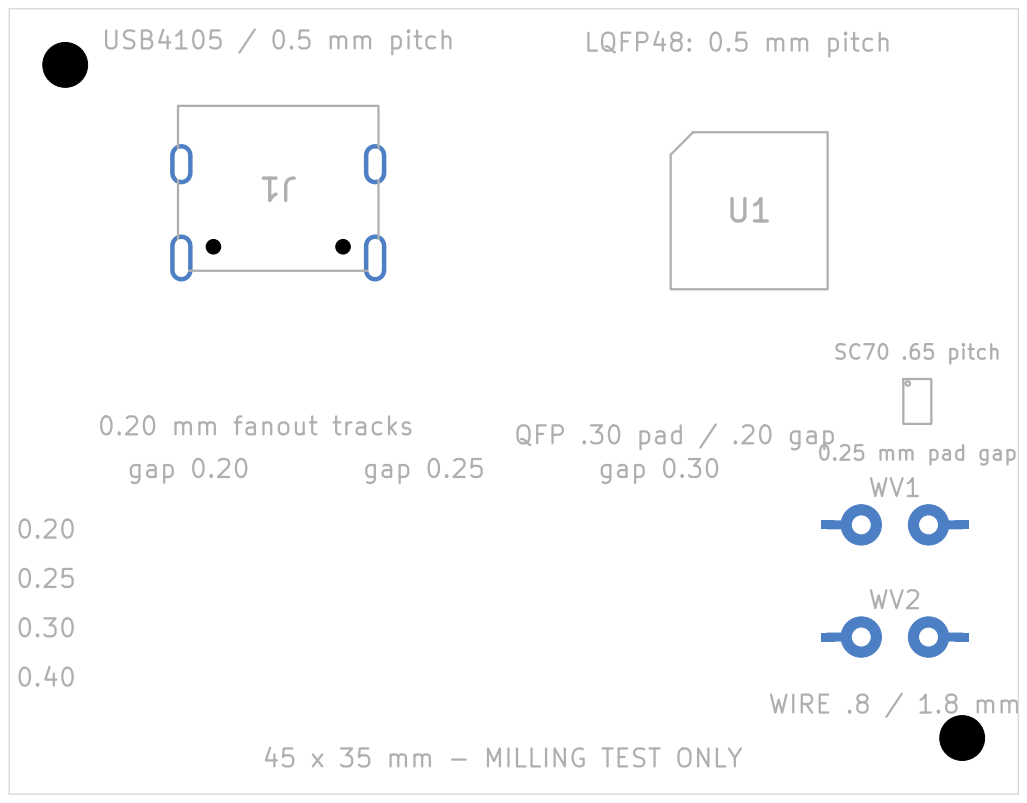
[picture p14: page 2]

0.20 mm fanout tracks USB4105 / 0.5 mm pitch

SC70 .65 pitch 0.25 mm pad gap 0.20

45 x 35 mm - MILLING TEST ONLY gap 0.30 QFP .30 pad / .20 gap
