opensimgear/device-template/electronics/boards/starter/0.1.0/home-milling/starter.kicad_pcb

## KiCad design electronics/boards/starter/0.1.0/home-milling/starter.kicad_pcb (2026-10-13)

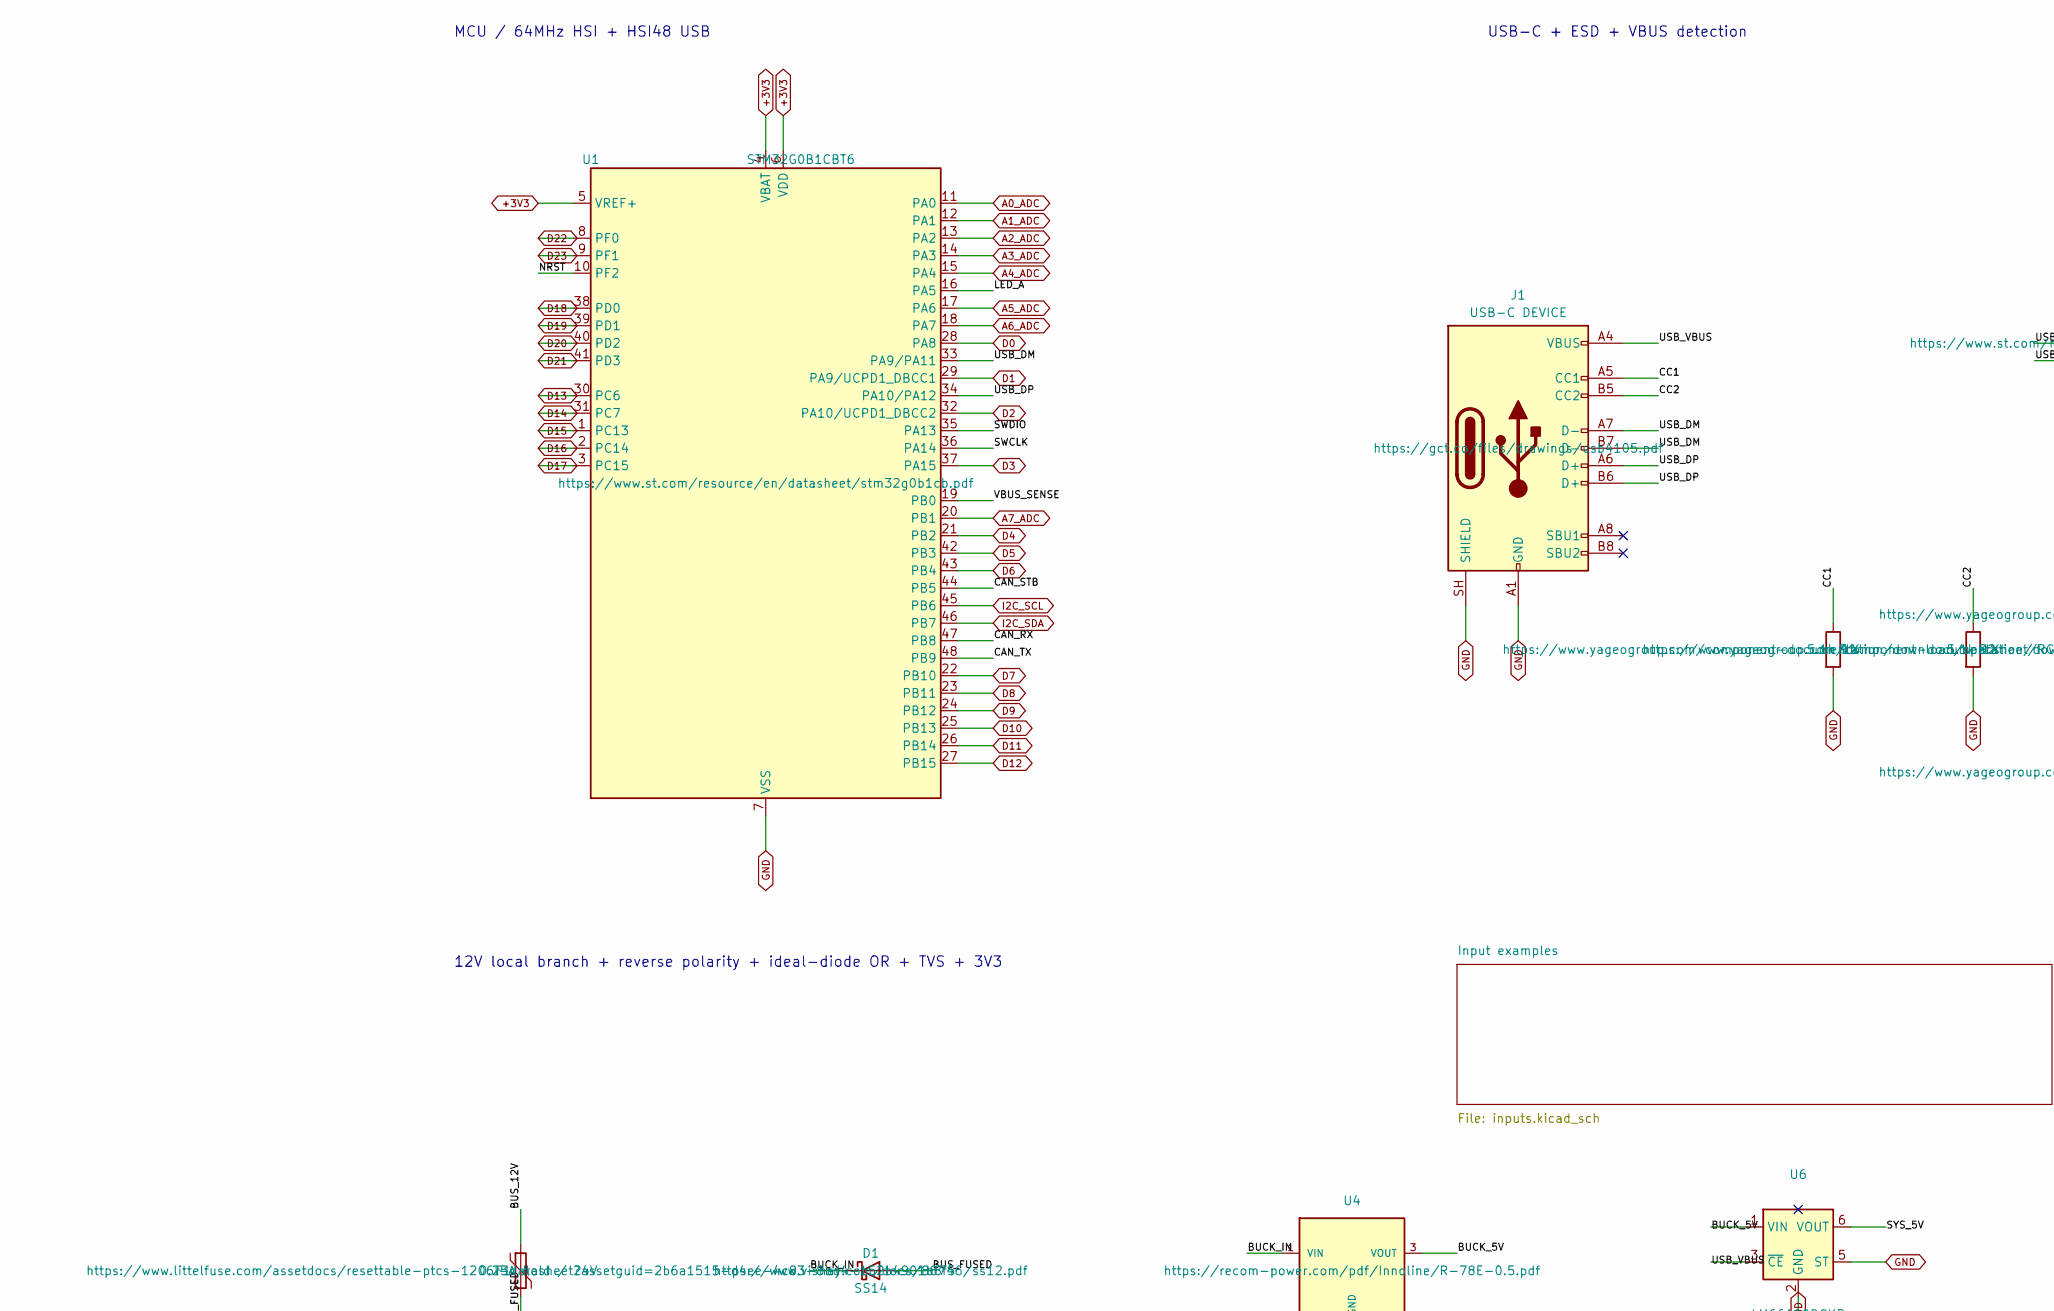
[picture p15: schematic starter.kicad_sch, OpenSimGear generic STM32G0B1 module, part in row 1, column 1]

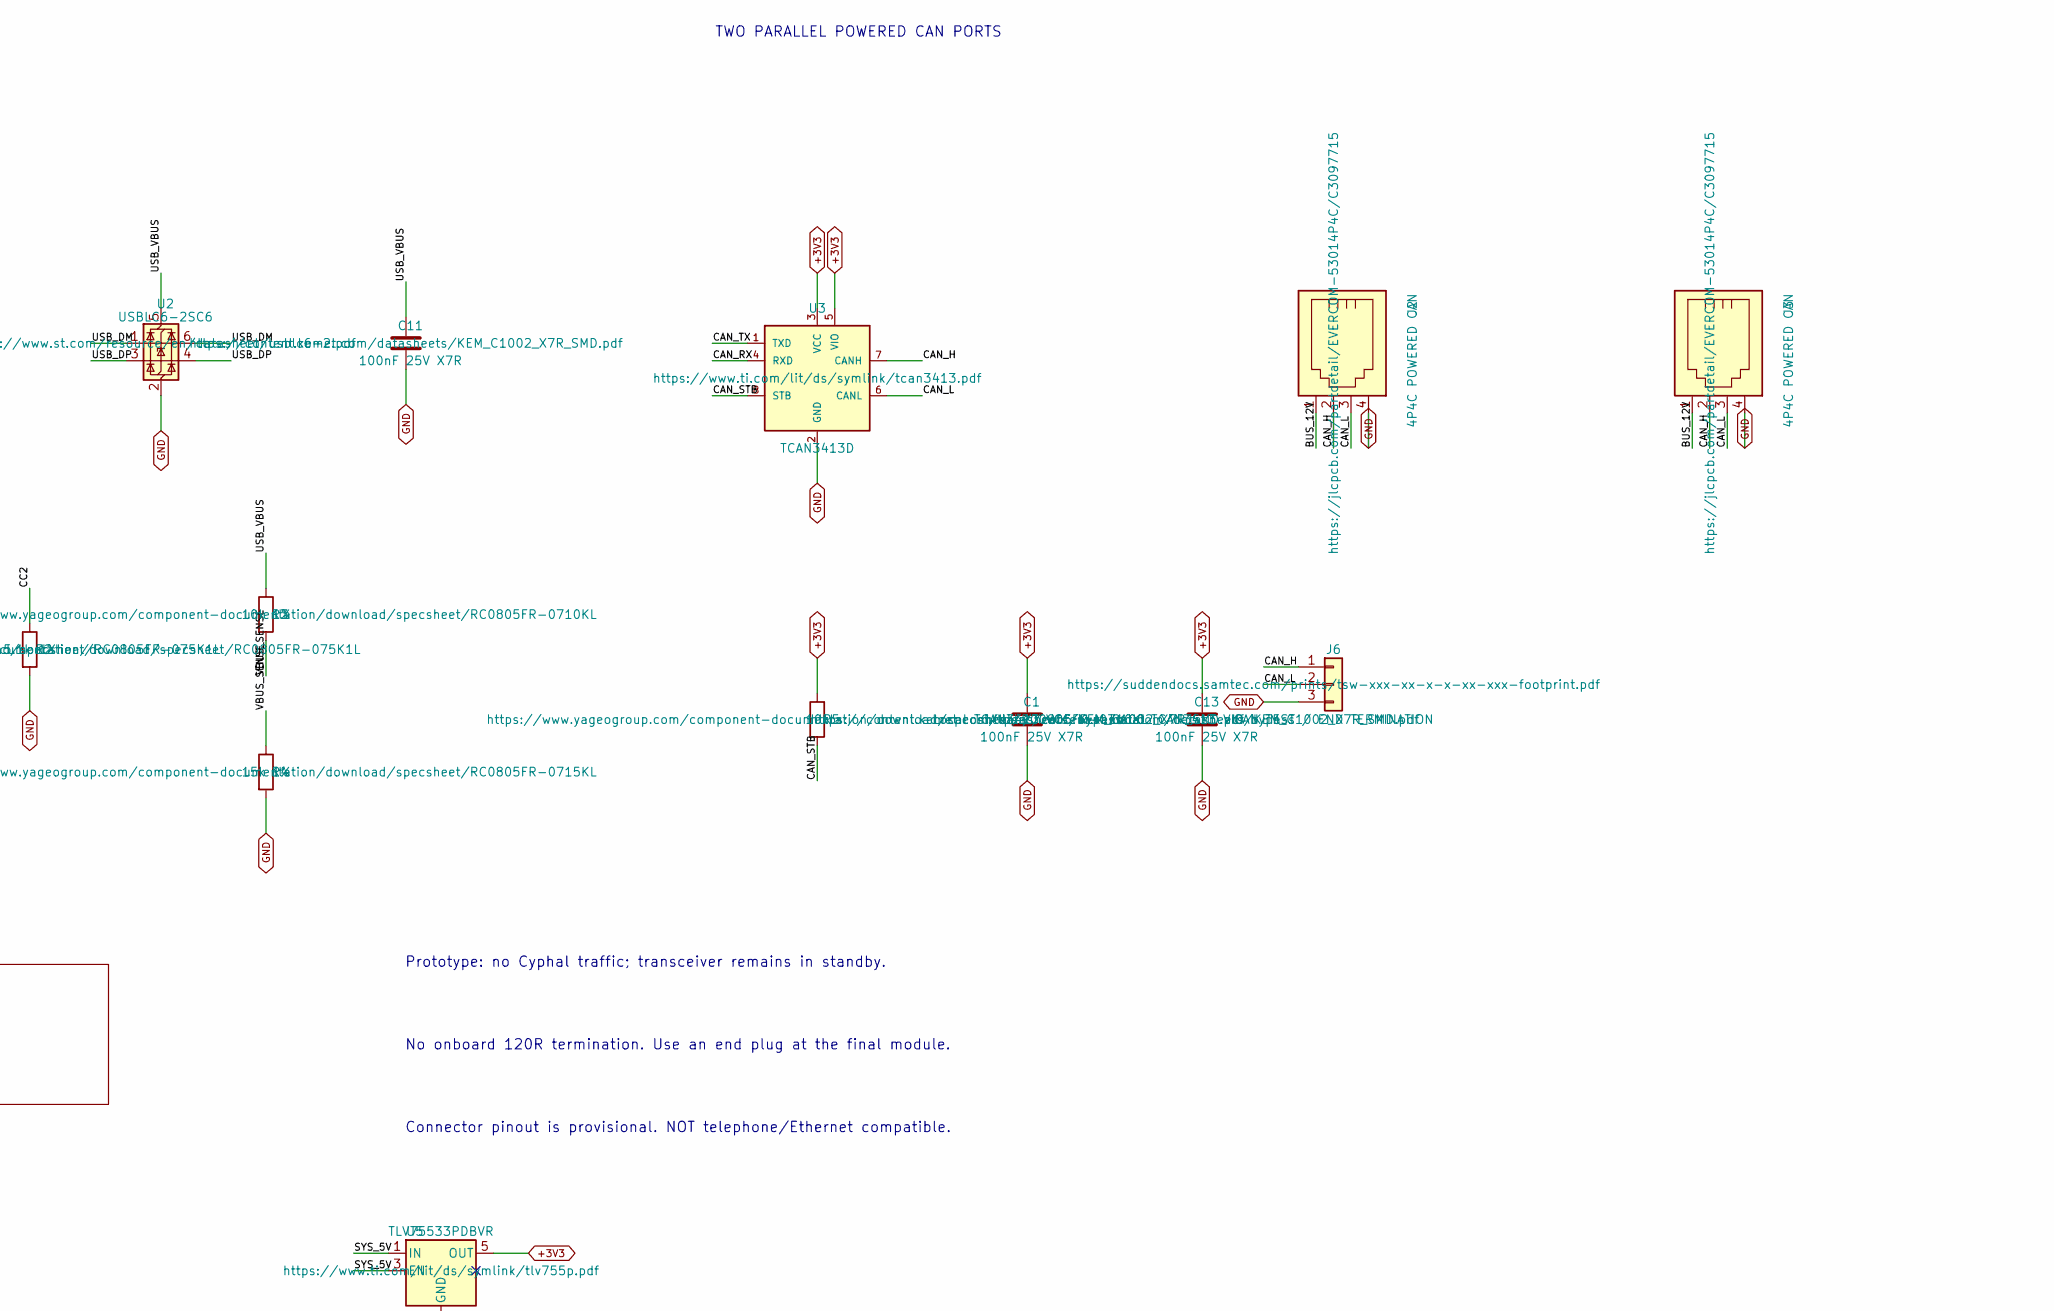
[picture p16: schematic starter.kicad_sch, OpenSimGear generic STM32G0B1 module, part in row 1, column 2]

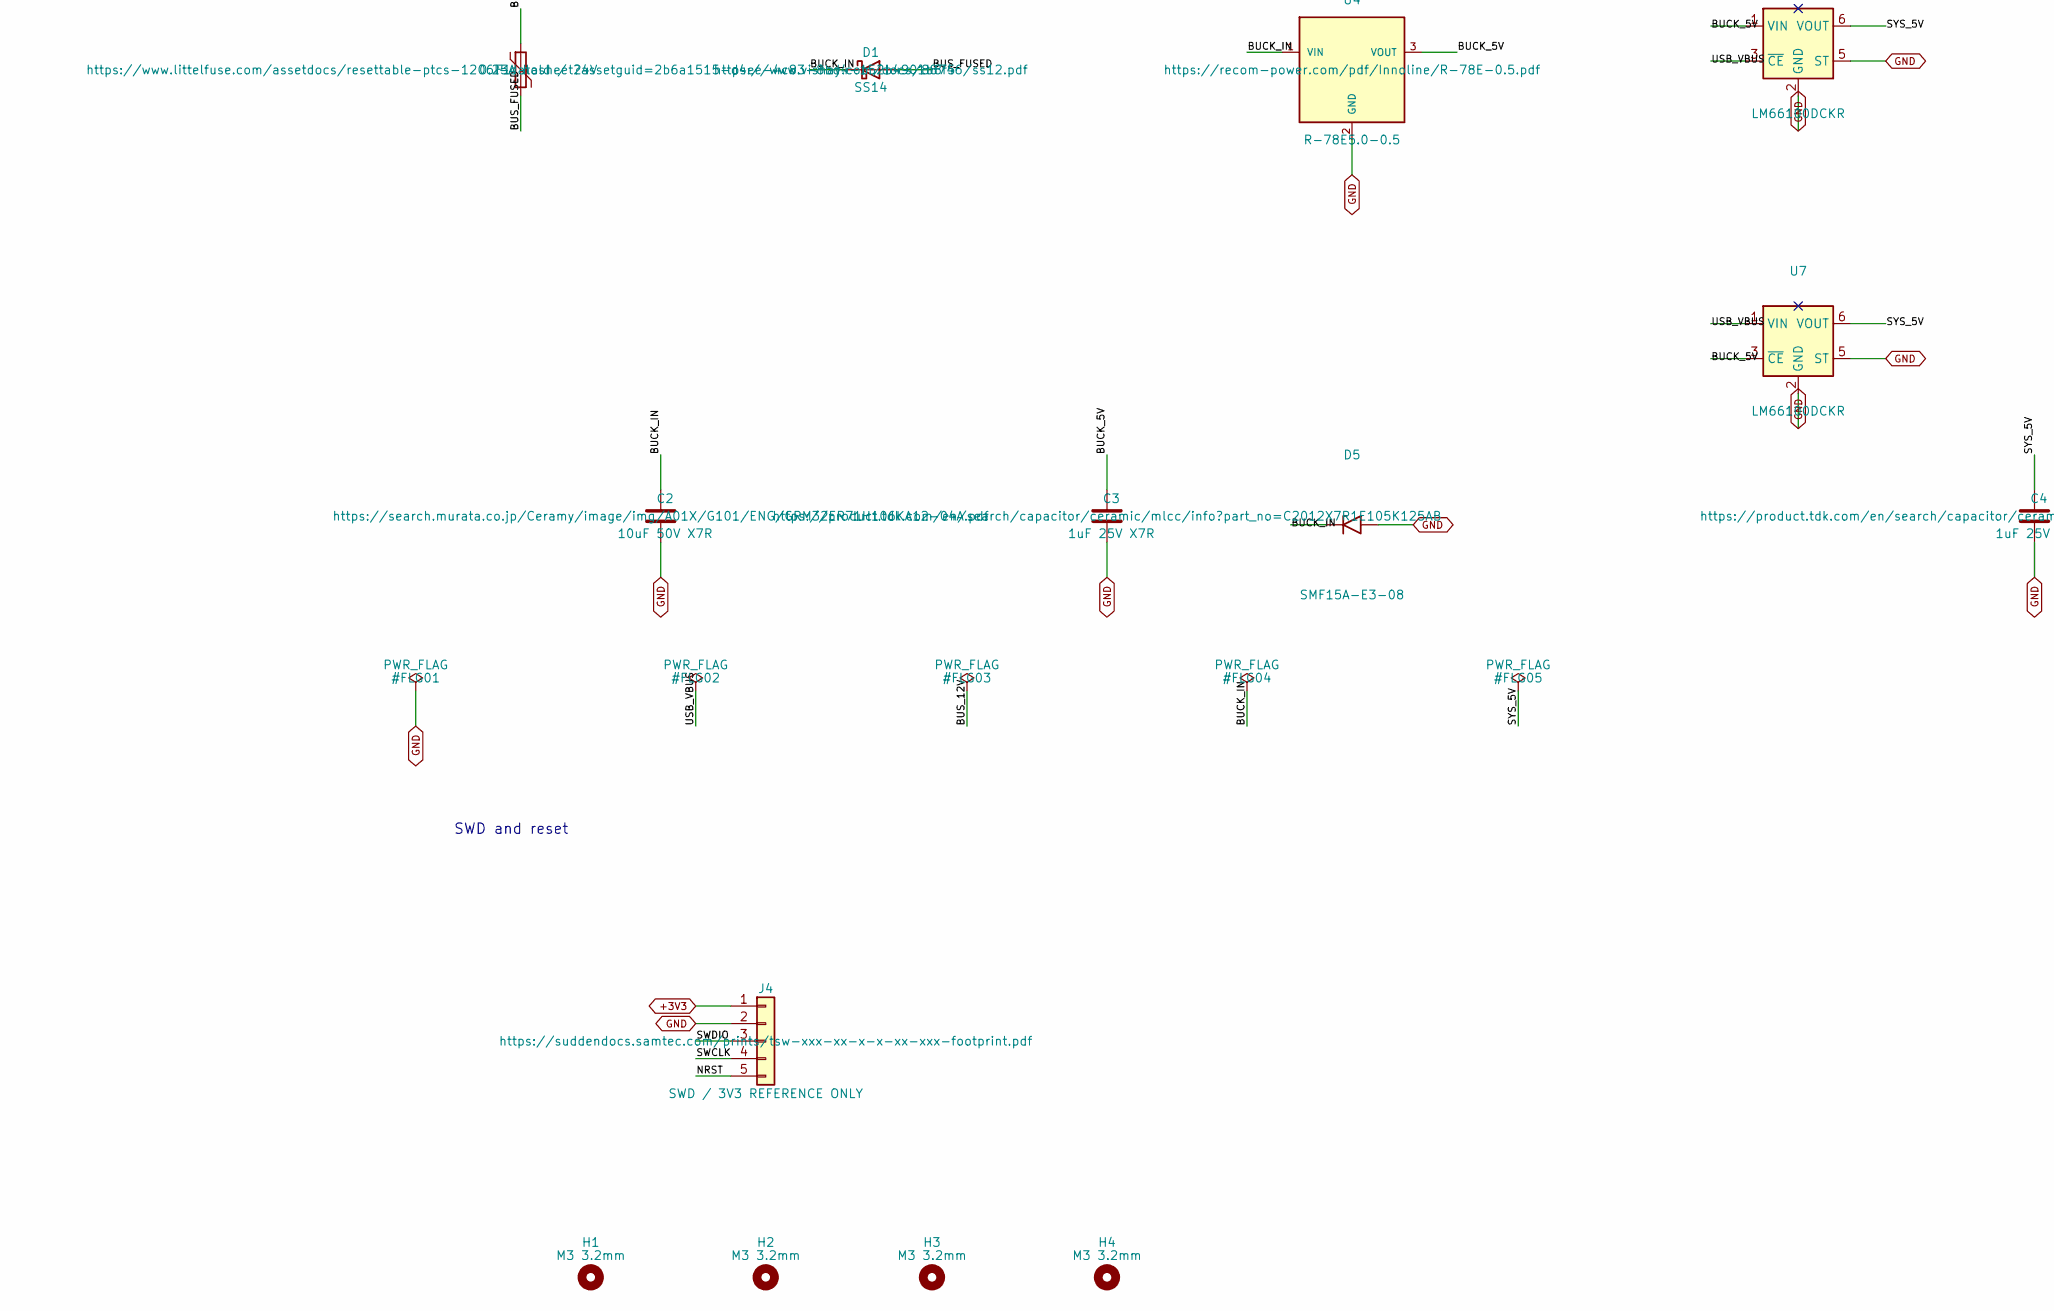
[picture p17: schematic starter.kicad_sch, OpenSimGear generic STM32G0B1 module, part in row 2, column 1]

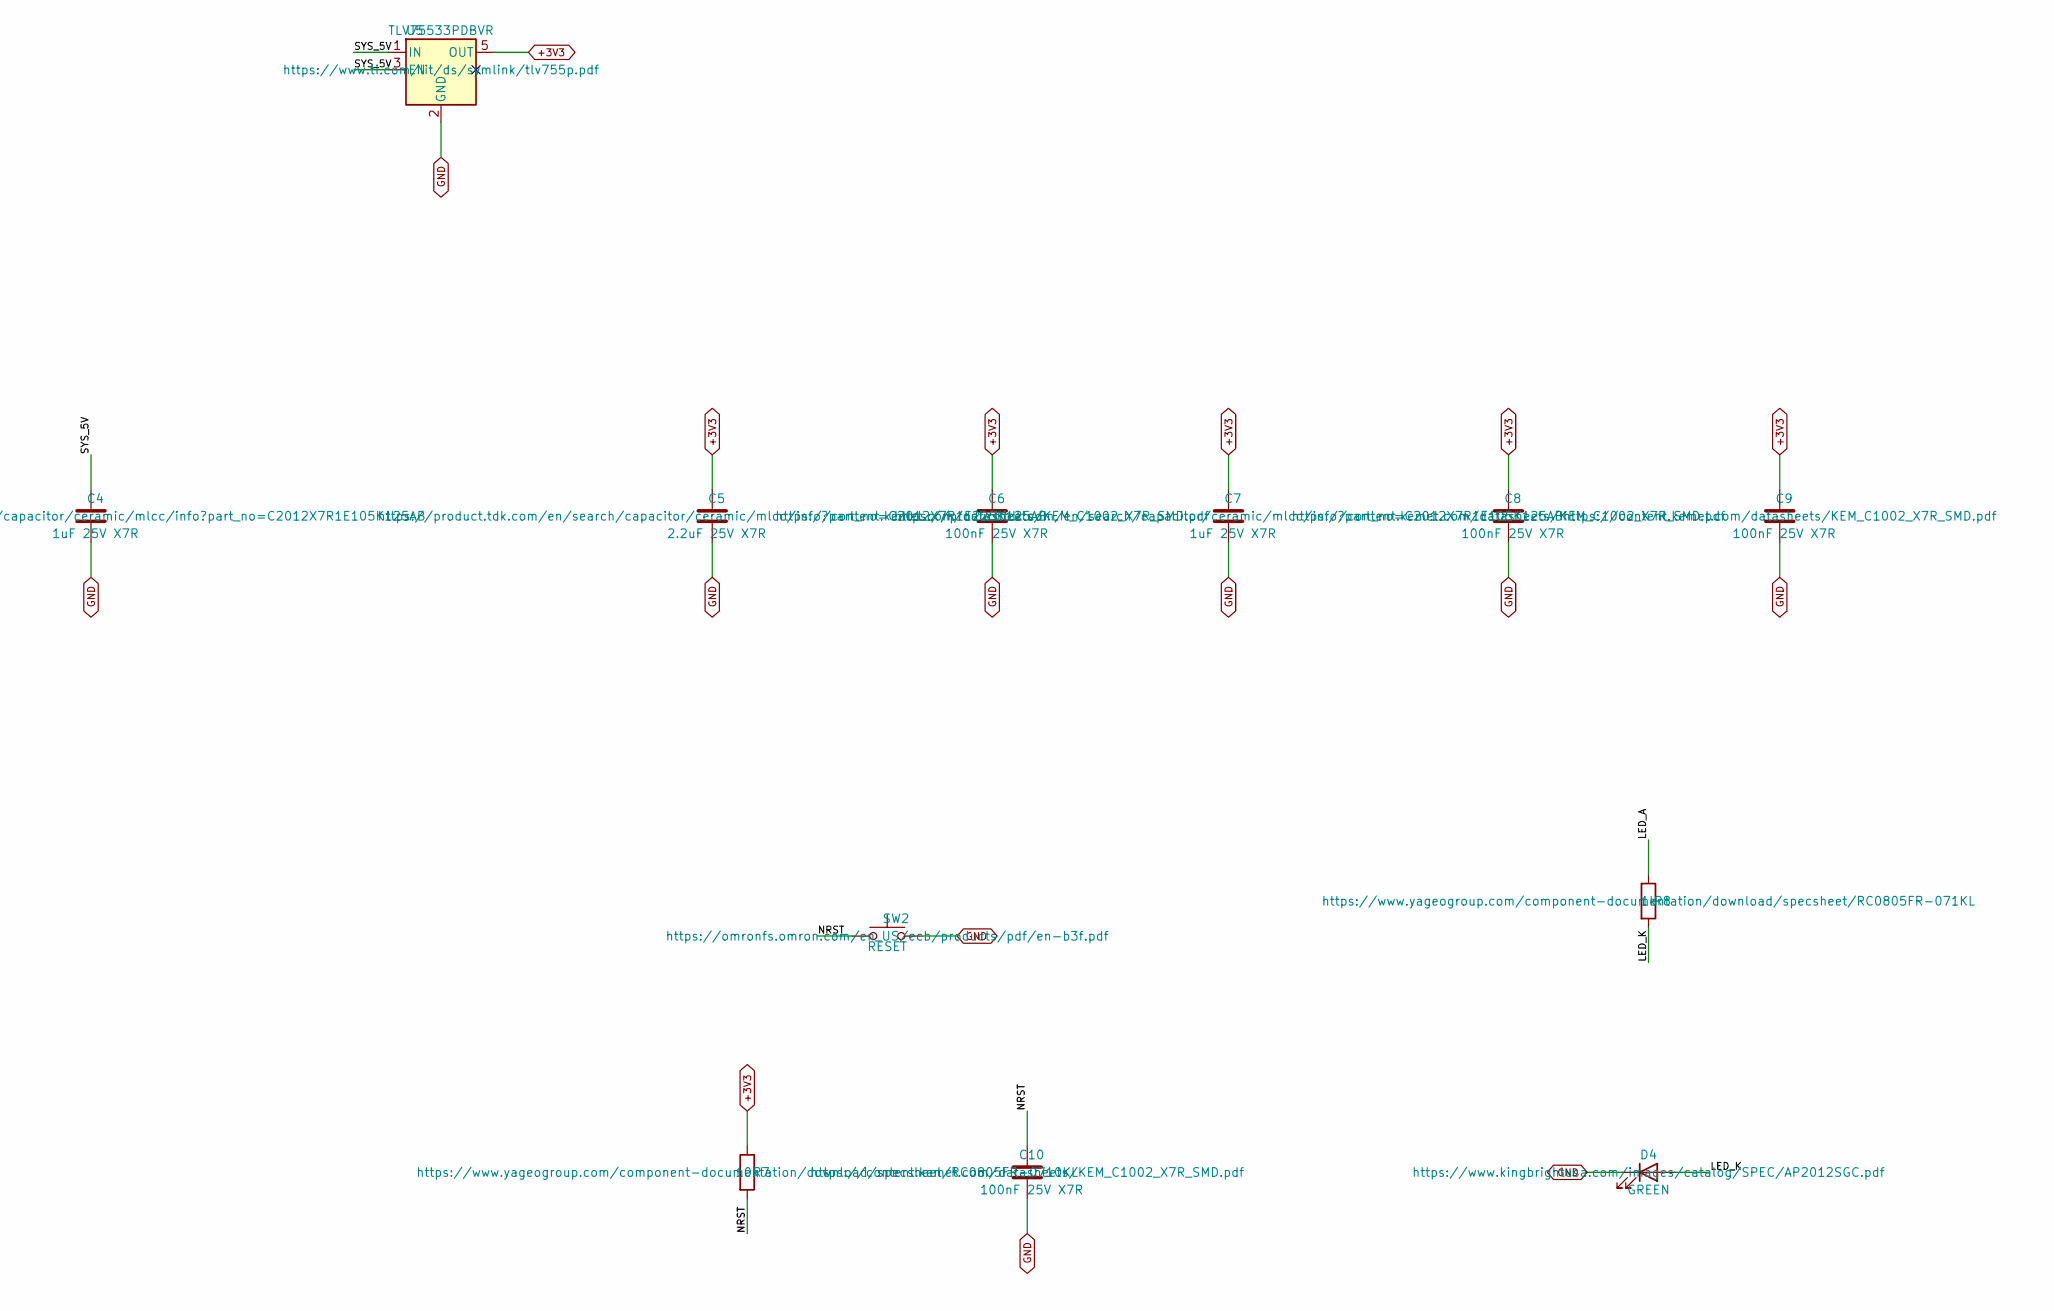
[picture p18: schematic starter.kicad_sch, OpenSimGear generic STM32G0B1 module, part in row 2, column 2]

Parts:
C1: 100nF 25V X7R; C1_C_0805_2012Metric_HomeMilling; MPN C0805C104K3RACTU
C2: 10uF 50V X7R; C2_C_1210_3225Metric_HomeMilling; MPN GRM32ER71H106KA12L
C3: 1uF 25V X7R; C3_C_0805_2012Metric_HomeMilling; MPN C2012X7R1E105K125AB
C4: 1uF 25V X7R; C4_C_0805_2012Metric_HomeMilling; MPN C2012X7R1E105K125AB
C5: 2.2uF 25V X7R; C5_C_0805_2012Metric_HomeMilling; MPN C2012X7R1E225K125AB
C6: 100nF 25V X7R; C6_C_0805_2012Metric_HomeMilling; MPN C0805C104K3RACTU
C7: 1uF 25V X7R; C7_C_0805_2012Metric_HomeMilling; MPN C2012X7R1E105K125AB
C8: 100nF 25V X7R; C8_C_0805_2012Metric_HomeMilling; MPN C0805C104K3RACTU
C9: 100nF 25V X7R; C9_C_0805_2012Metric_HomeMilling; MPN C0805C104K3RACTU
C10: 100nF 25V X7R; C10_C_0805_2012Metric_HomeMilling; MPN C0805C104K3RACTU
C11: 100nF 25V X7R; C11_C_0805_2012Metric_HomeMilling; MPN C0805C104K3RACTU
C13: 100nF 25V X7R; C13_C_0805_2012Metric_HomeMilling; MPN C0805C104K3RACTU
D1: SS14; D1_D_SMA_HomeMilling; MPN SS14-E3/61T
D4: GREEN; D4_LED_Kingbright_AP2012SGC_0805_HomeMilling; MPN AP2012SGC
D5: SMF15A-E3-08; D5_D_SMF_HomeMilling; MPN SMF15A-E3-08
F1: 0.25A hold / 24V; F1_Fuse_Littelfuse_1206L025-24YR_HomeMilling; MPN 1206L025/24YR
H1: M3 3.2mm; H1_MountingHole_3.2mm_M3_HomeMilling
H2: M3 3.2mm; H2_MountingHole_3.2mm_M3_HomeMilling
H3: M3 3.2mm; H3_MountingHole_3.2mm_M3_HomeMilling
H4: M3 3.2mm; H4_MountingHole_3.2mm_M3_HomeMilling
J1: USB-C DEVICE; J1_USB_C_Receptacle_GCT_USB4105-xx-A_16P_TopMnt_Horizontal_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; MPN USB4105-GF-A
J2: 4P4C POWERED CAN; J2_RJ4P4C_Evercom_5301-4P4C_Horizontal_HomeMilling; MPN 5301-4P4C
J3: 4P4C POWERED CAN; J3_RJ4P4C_Evercom_5301-4P4C_Horizontal_HomeMilling; MPN 5301-4P4C
J4: SWD / 3V3 REFERENCE ONLY; J4_PinHeader_Samtec_TSW-105-07-L-S_P2.54mm_Vertical_HomeMil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; MPN TSW-105-07-L-S
J6: CAN TEST / END TERMINATION; J6_PinHeader_Samtec_TSW-103-07-L-S_P2.54mm_Vertical_HomeMil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; MPN TSW-103-07-L-S
R1: 5.1k 1%; R1_R_0805_2012Metric_HomeMilling; MPN RC0805FR-075K1L
R2: 5.1k 1%; R2_R_0805_2012Metric_HomeMilling; MPN RC0805FR-075K1L
R3: 10k 1%; R3_R_0805_2012Metric_HomeMilling; MPN RC0805FR-0710KL
R4: 15k 1%; R4_R_0805_2012Metric_HomeMilling; MPN RC0805FR-0715KL
R5: 10k; R5_R_0805_2012Metric_HomeMilling; MPN RC0805FR-0710KL
R7: 10k; R7_R_0805_2012Metric_HomeMilling; MPN RC0805FR-0710KL
R8: 1k; R8_R_0805_2012Metric_HomeMilling; MPN RC0805FR-071KL
SW2: RESET; SW2_SW_PUSH_6mm_H4.3mm_HomeMilling; MPN B3F-1002-G
U1: STM32G0B1CBT6; U1_LQFP-48_7x7mm_P0.5mm_HomeMilling; MPN STM32G0B1CBT6
U2: USBLC6-2SC6; U2_SOT-23-6_HomeMilling; MPN USBLC6-2SC6
U3: TCAN3413D; U3_SOIC-8_3.9x4.9mm_P1.27mm_HomeMilling; MPN TCAN3413D
U4: R-78E5.0-0.5; U4_Converter_DCDC_RECOM_R-78E-0.5_THT_HomeMilling; MPN R-78E5.0-0.5
U5: TLV75533PDBVR; U5_SOT-23-5_HomeMilling; MPN TLV75533PDBVR
U6: LM66100DCKR; U6_TI_DCK0006A_SC70-6_LM66100_HomeMilling; MPN LM66100DCKR
U7: LM66100DCKR; U7_TI_DCK0006A_SC70-6_LM66100_HomeMilling; MPN LM66100DCKR

Connections:
+3V3: C1.1, C5.1, C6.1, C7.1, C8.1, C9.1, C13.1, J4.1, R5.1, R7.1, U1.4 (VBAT), U1.5 (VREF+), U1.6 (VDD), U3.3 (VCC), U3.5 (VIO), U5.5 (OUT); also elsewhere on the board
/BUCK_5V: C3.1, U4.3 (VOUT), U6.1 (VIN), U7.3 (~CE)
/BUCK_IN: C2.1, D1.1 (K), D5.1 (A1), U4.1 (VIN)
/BUS_12V: F1.1, J2.1, J3.1
/BUS_FUSED: D1.2 (A), F1.2
/CAN_H: J2.2, J3.2, J6.1, U3.7 (CANH)
/CAN_L: J2.3, J3.3, J6.2, U3.6 (CANL)
/CAN_RX: U1.47 (PB8), U3.4 (RXD)
/CAN_STB: R5.2, U1.44 (PB5), U3.8 (STB)
/CAN_TX: U1.48 (PB9), U3.1 (TXD)
/CC1: J1.A5 (CC1), R1.1
/CC2: J1.B5 (CC2), R2.1
/LED_A: R8.1, U1.16 (PA5)
/LED_K: D4.2 (A), R8.2
/NRST: C10.1, J4.5, R7.2, SW2.1, U1.10 (PF2)
/SWCLK: J4.4, U1.36 (PA14)
/SWDIO: J4.3, U1.35 (PA13)
/SYS_5V: C4.1, U5.1 (IN), U5.3 (EN), U6.6 (VOUT), U7.6 (VOUT)
/USB_DM: J1.A7 (D-), J1.B7 (D-), U1.33 (PA9/PA11), U2.1 (I/O1), U2.6 (I/O1)
/USB_DP: J1.A6 (D+), J1.B6 (D+), U1.34 (PA10/PA12), U2.3 (I/O2), U2.4 (I/O2)
/USB_VBUS: C11.1, J1.A4 (VBUS), J1.A9 (VBUS), J1.B4 (VBUS), J1.B9 (VBUS), R3.1, U2.5 (VBUS), U6.3 (~CE), U7.1 (VIN)
/VBUS_SENSE: R3.2, R4.1, U1.19 (PB0)
A0_ADC: U1.11 (PA0); also elsewhere on the board
A1_ADC: U1.12 (PA1); also elsewhere on the board
A2_ADC: U1.13 (PA2); also elsewhere on the board
A3_ADC: U1.14 (PA3); also elsewhere on the board
A4_ADC: U1.15 (PA4); also elsewhere on the board
A5_ADC: U1.17 (PA6); also elsewhere on the board
A6_ADC: U1.18 (PA7); also elsewhere on the board
A7_ADC: U1.20 (PB1); also elsewhere on the board
D0: U1.28 (PA8); also elsewhere on the board
D1: U1.29 (PA9/UCPD1_DBCC1); also elsewhere on the board
D2: U1.32 (PA10/UCPD1_DBCC2); also elsewhere on the board
D3: U1.37 (PA15); also elsewhere on the board
D4: U1.21 (PB2); also elsewhere on the board
D5: U1.42 (PB3); also elsewhere on the board
D6: U1.43 (PB4); also elsewhere on the board
D7: U1.22 (PB10); also elsewhere on the board
D8: U1.23 (PB11); also elsewhere on the board
D9: U1.24 (PB12); also elsewhere on the board
D10: U1.25 (PB13); also elsewhere on the board
D11: U1.26 (PB14); also elsewhere on the board
D12: U1.27 (PB15); also elsewhere on the board
D13: U1.30 (PC6); also elsewhere on the board
D14: U1.31 (PC7); also elsewhere on the board
D15: U1.1 (PC13); also elsewhere on the board
D16: U1.2 (PC14); also elsewhere on the board
D17: U1.3 (PC15); also elsewhere on the board
D18: U1.38 (PD0); also elsewhere on the board
D19: U1.39 (PD1); also elsewhere on the board
D20: U1.40 (PD2); also elsewhere on the board
D21: U1.41 (PD3); also elsewhere on the board
D22: U1.8 (PF0); also elsewhere on the board
D23: U1.9 (PF1); also elsewhere on the board
GND: C1.2, C2.2, C3.2, C4.2, C5.2, C6.2, C7.2, C8.2, C9.2, C10.2, C11.2, C13.2, D4.1 (K), D5.2 (A2), J1.A1 (GND), J1.A12 (GND), J1.B1 (GND), J1.B12 (GND), J1.SH (SHIELD), J2.4, J3.4, J4.2, J6.3, R1.2, R2.2, R4.2, SW2.2, U1.7 (VSS), U2.2 (GND), U3.2 (GND), U4.2 (GND), U5.2 (GND), U6.2 (GND), U6.5 (ST), U7.2 (GND), U7.5 (ST); also elsewhere on the board
I2C_SCL: U1.45 (PB6); also elsewhere on the board
I2C_SDA: U1.46 (PB7); also elsewhere on the board

Notes on the sheet:
MCU / 64MHz HSI + HSI48 USB
USB-C + ESD + VBUS detection
TWO PARALLEL POWERED CAN PORTS
12V local branch + reverse polarity + ideal-diode OR + TVS + 3V3
SWD and reset
Prototype: no Cyphal traffic; transceiver remains in standby.
No onboard 120R termination. Use an end plug at the final module.
Connector pinout is provisional. NOT telephone/Ethernet compatible.
