opensimgear/device-template/electronics/boards/starter/0.1.0/home-milling/starter.kicad_pcb

## KiCad design electronics/boards/starter/0.1.0/home-milling/starter.kicad_pcb (continued)

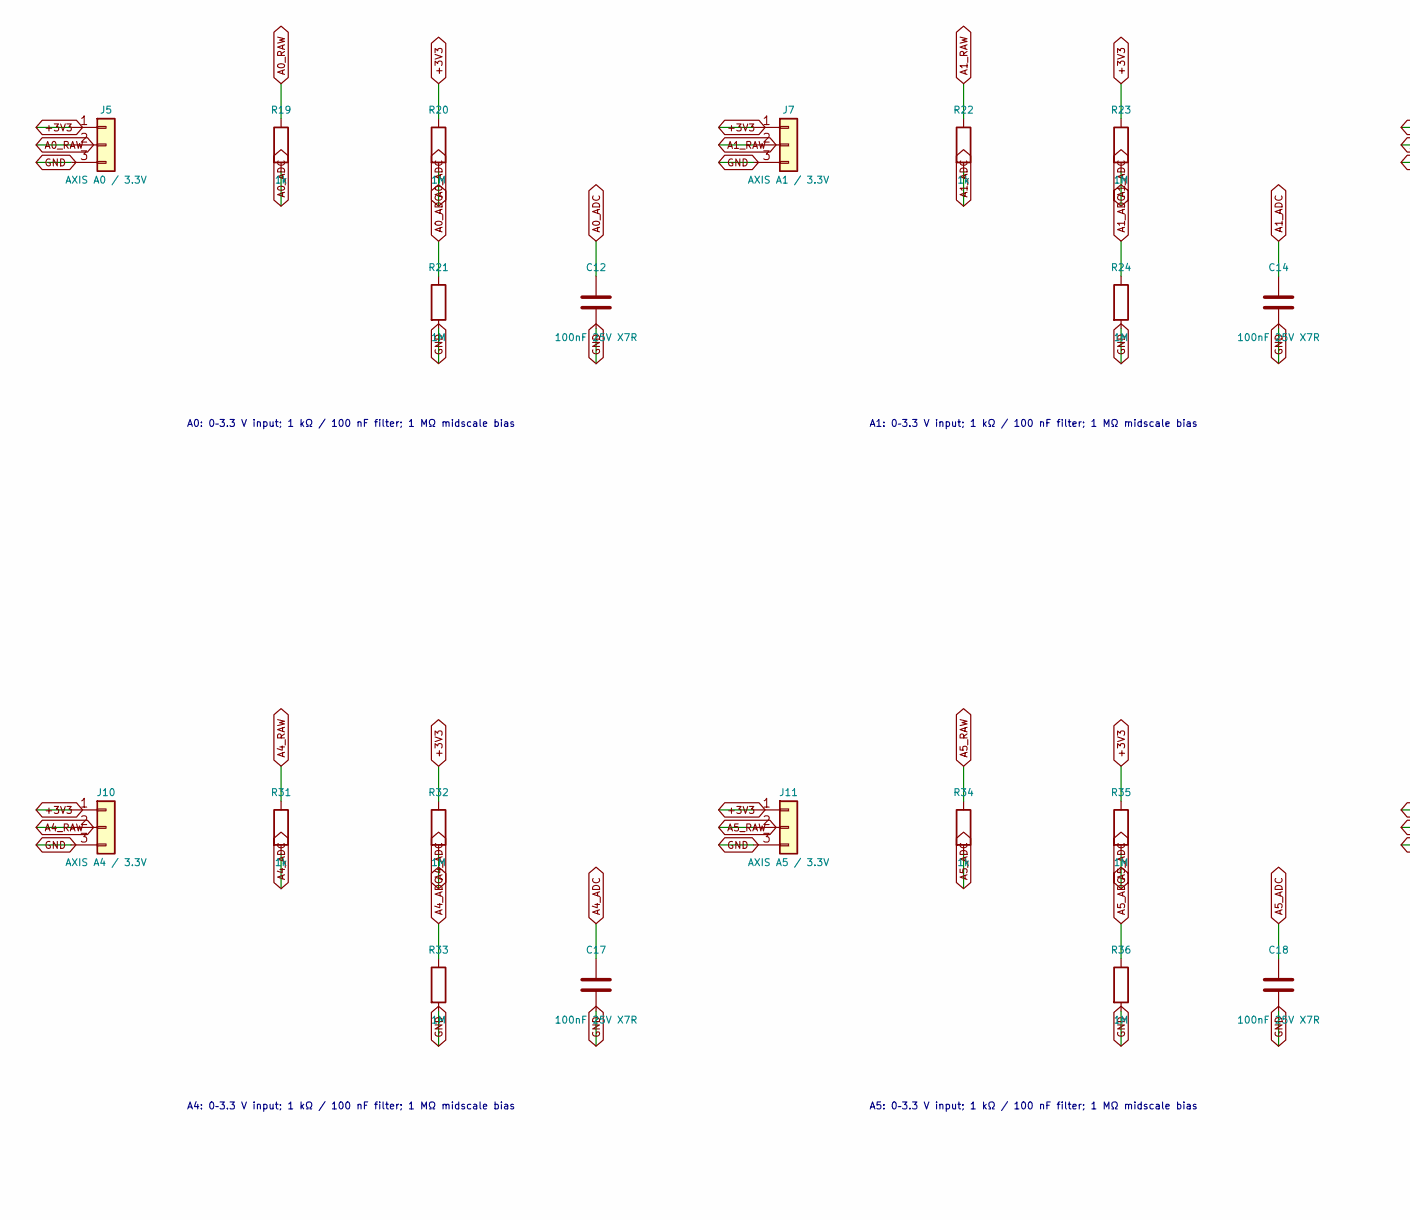
[picture p19: schematic inputs.kicad_sch, OpenSimGear generic input banks, part in row 1, column 1]

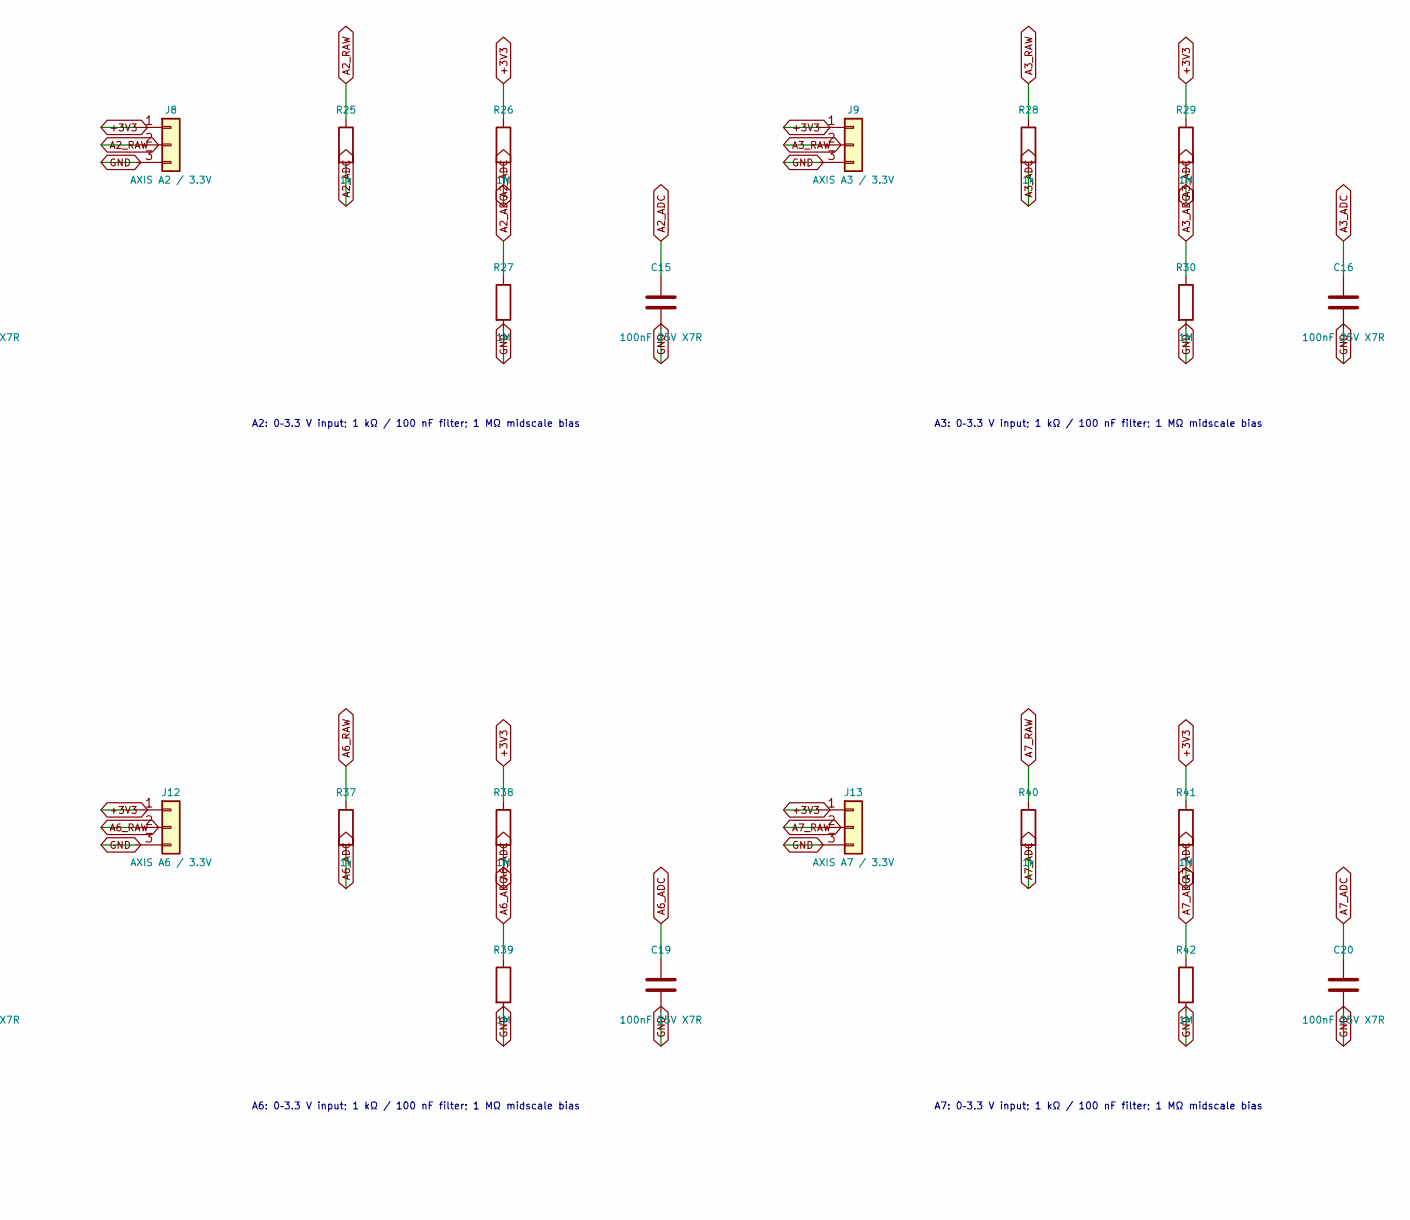
[picture p20: schematic inputs.kicad_sch, OpenSimGear generic input banks, part in row 1, column 2]

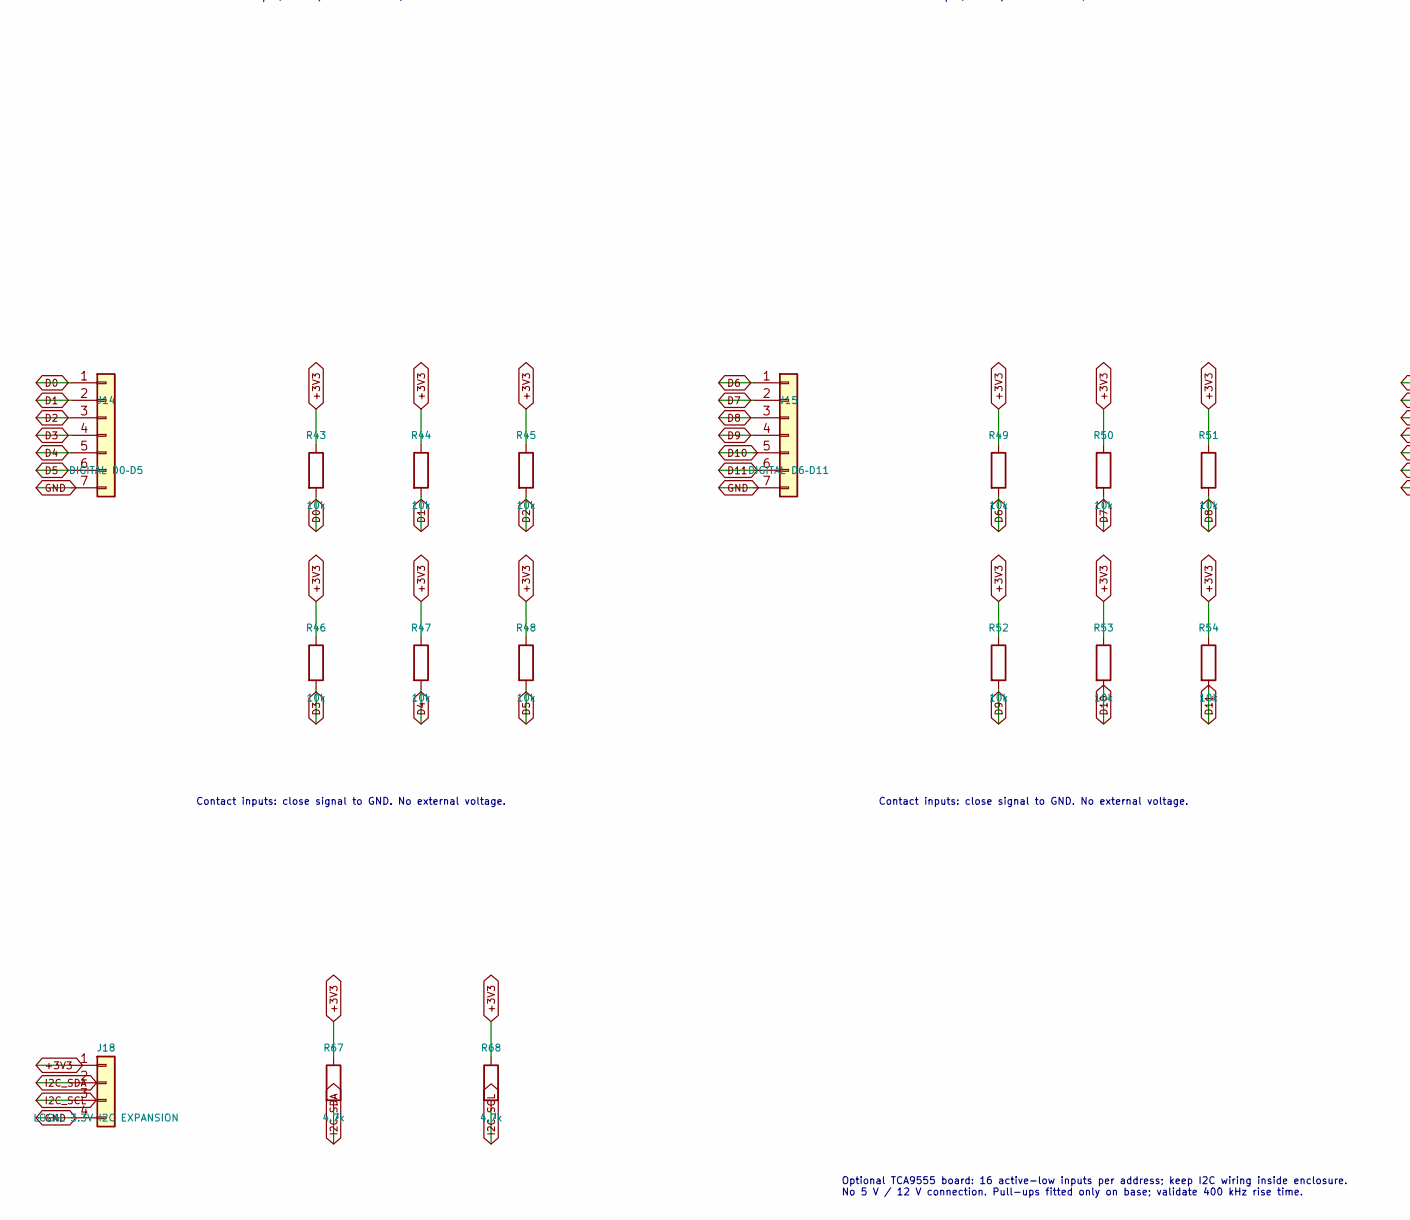
[picture p21: schematic inputs.kicad_sch, OpenSimGear generic input banks, part in row 2, column 1]

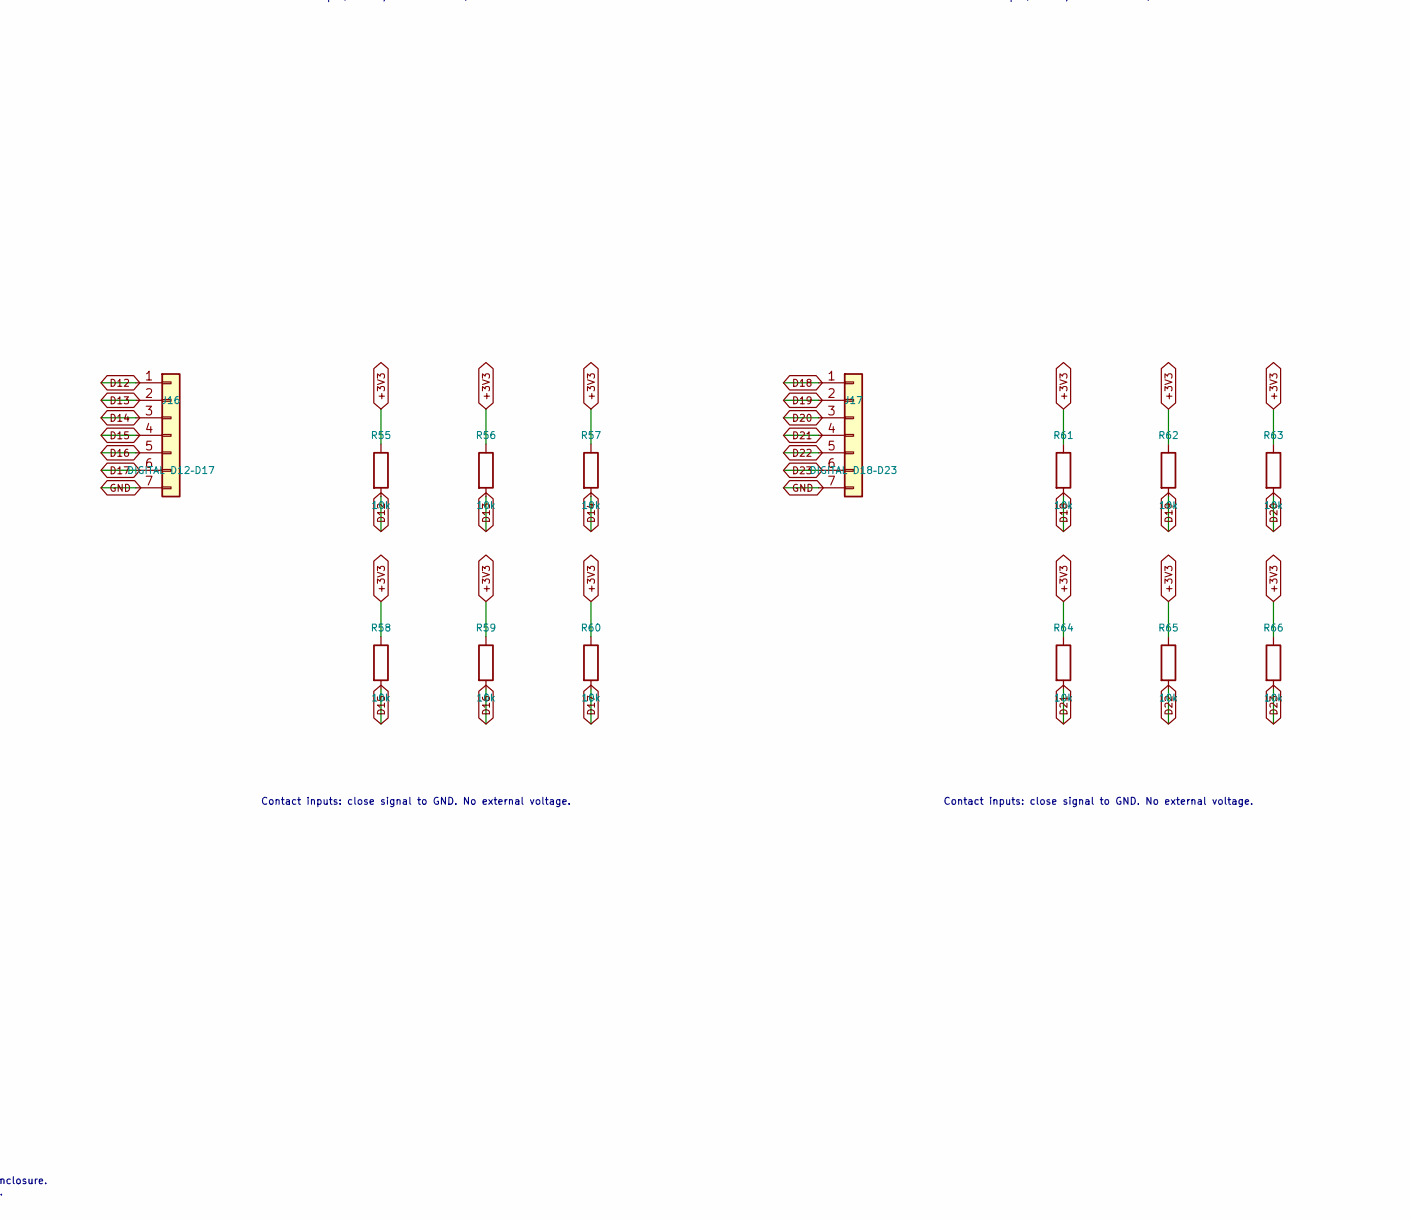
[picture p22: schematic inputs.kicad_sch, OpenSimGear generic input banks, part in row 2, column 2]

Parts:
C12: 100nF 25V X7R; C12_C_0805_2012Metric_HomeMilling; MPN C0805C104K3RACTU
C14: 100nF 25V X7R; C14_C_0805_2012Metric_HomeMilling; MPN C0805C104K3RACTU
C15: 100nF 25V X7R; C15_C_0805_2012Metric_HomeMilling; MPN C0805C104K3RACTU
C16: 100nF 25V X7R; C16_C_0805_2012Metric_HomeMilling; MPN C0805C104K3RACTU
C17: 100nF 25V X7R; C17_C_0805_2012Metric_HomeMilling; MPN C0805C104K3RACTU
C18: 100nF 25V X7R; C18_C_0805_2012Metric_HomeMilling; MPN C0805C104K3RACTU
C19: 100nF 25V X7R; C19_C_0805_2012Metric_HomeMilling; MPN C0805C104K3RACTU
C20: 100nF 25V X7R; C20_C_0805_2012Metric_HomeMilling; MPN C0805C104K3RACTU
J5: AXIS A0 / 3.3V; J5_PinHeader_Samtec_TSW-103-07-L-S_P2.54mm_Vertical_HomeMil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; MPN TSW-103-07-L-S
J7: AXIS A1 / 3.3V; J7_PinHeader_Samtec_TSW-103-07-L-S_P2.54mm_Vertical_HomeMil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; MPN TSW-103-07-L-S
J8: AXIS A2 / 3.3V; J8_PinHeader_Samtec_TSW-103-07-L-S_P2.54mm_Vertical_HomeMil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; MPN TSW-103-07-L-S
J9: AXIS A3 / 3.3V; J9_PinHeader_Samtec_TSW-103-07-L-S_P2.54mm_Vertical_HomeMil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; MPN TSW-103-07-L-S
J10: AXIS A4 / 3.3V; J10_PinHeader_Samtec_TSW-103-07-L-S_P2.54mm_Vertical_HomeMi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; MPN TSW-103-07-L-S
J11: AXIS A5 / 3.3V; J11_PinHeader_Samtec_TSW-103-07-L-S_P2.54mm_Vertical_HomeMi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; MPN TSW-103-07-L-S
J12: AXIS A6 / 3.3V; J12_PinHeader_Samtec_TSW-103-07-L-S_P2.54mm_Vertical_HomeMi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; MPN TSW-103-07-L-S
J13: AXIS A7 / 3.3V; J13_PinHeader_Samtec_TSW-103-07-L-S_P2.54mm_Vertical_HomeMi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; MPN TSW-103-07-L-S
J14: DIGITAL D0–D5; J14_PinHeader_Samtec_TSW-107-07-L-S_P2.54mm_Vertical_HomeMi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; MPN TSW-107-07-L-S
J15: DIGITAL D6–D11; J15_PinHeader_Samtec_TSW-107-07-L-S_P2.54mm_Vertical_HomeMi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; MPN TSW-107-07-L-S
J16: DIGITAL D12–D17; J16_PinHeader_Samtec_TSW-107-07-L-S_P2.54mm_Vertical_HomeMi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; MPN TSW-107-07-L-S
J17: DIGITAL D18–D23; J17_PinHeader_Samtec_TSW-107-07-L-S_P2.54mm_Vertical_HomeMi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; MPN TSW-107-07-L-S
J18: LOCAL 3.3V I2C EXPANSION; J18_PinHeader_Samtec_TSW-104-07-L-S_P2.54mm_Vertical_HomeMi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; MPN TSW-104-07-L-S
R19: 1k; R19_R_0805_2012Metric_HomeMilling; MPN RC0805FR-071KL
R20: 1M; R20_R_0805_2012Metric_HomeMilling; MPN RC0805FR-071ML
R21: 1M; R21_R_0805_2012Metric_HomeMilling; MPN RC0805FR-071ML
R22: 1k; R22_R_0805_2012Metric_HomeMilling; MPN RC0805FR-071KL
R23: 1M; R23_R_0805_2012Metric_HomeMilling; MPN RC0805FR-071ML
R24: 1M; R24_R_0805_2012Metric_HomeMilling; MPN RC0805FR-071ML
R25: 1k; R25_R_0805_2012Metric_HomeMilling; MPN RC0805FR-071KL
R26: 1M; R26_R_0805_2012Metric_HomeMilling; MPN RC0805FR-071ML
R27: 1M; R27_R_0805_2012Metric_HomeMilling; MPN RC0805FR-071ML
R28: 1k; R28_R_0805_2012Metric_HomeMilling; MPN RC0805FR-071KL
R29: 1M; R29_R_0805_2012Metric_HomeMilling; MPN RC0805FR-071ML
R30: 1M; R30_R_0805_2012Metric_HomeMilling; MPN RC0805FR-071ML
R31: 1k; R31_R_0805_2012Metric_HomeMilling; MPN RC0805FR-071KL
R32: 1M; R32_R_0805_2012Metric_HomeMilling; MPN RC0805FR-071ML
R33: 1M; R33_R_0805_2012Metric_HomeMilling; MPN RC0805FR-071ML
R34: 1k; R34_R_0805_2012Metric_HomeMilling; MPN RC0805FR-071KL
R35: 1M; R35_R_0805_2012Metric_HomeMilling; MPN RC0805FR-071ML
R36: 1M; R36_R_0805_2012Metric_HomeMilling; MPN RC0805FR-071ML
R37: 1k; R37_R_0805_2012Metric_HomeMilling; MPN RC0805FR-071KL
R38: 1M; R38_R_0805_2012Metric_HomeMilling; MPN RC0805FR-071ML
R39: 1M; R39_R_0805_2012Metric_HomeMilling; MPN RC0805FR-071ML
R40: 1k; R40_R_0805_2012Metric_HomeMilling; MPN RC0805FR-071KL
R41: 1M; R41_R_0805_2012Metric_HomeMilling; MPN RC0805FR-071ML
R42: 1M; R42_R_0805_2012Metric_HomeMilling; MPN RC0805FR-071ML
R43: 10k; R43_R_0805_2012Metric_HomeMilling; MPN RC0805FR-0710KL
R44: 10k; R44_R_0805_2012Metric_HomeMilling; MPN RC0805FR-0710KL
R45: 10k; R45_R_0805_2012Metric_HomeMilling; MPN RC0805FR-0710KL
R46: 10k; R46_R_0805_2012Metric_HomeMilling; MPN RC0805FR-0710KL
R47: 10k; R47_R_0805_2012Metric_HomeMilling; MPN RC0805FR-0710KL
R48: 10k; R48_R_0805_2012Metric_HomeMilling; MPN RC0805FR-0710KL
R49: 10k; R49_R_0805_2012Metric_HomeMilling; MPN RC0805FR-0710KL
R50: 10k; R50_R_0805_2012Metric_HomeMilling; MPN RC0805FR-0710KL
R51: 10k; R51_R_0805_2012Metric_HomeMilling; MPN RC0805FR-0710KL
R52: 10k; R52_R_0805_2012Metric_HomeMilling; MPN RC0805FR-0710KL
R53: 10k; R53_R_0805_2012Metric_HomeMilling; MPN RC0805FR-0710KL
R54: 10k; R54_R_0805_2012Metric_HomeMilling; MPN RC0805FR-0710KL
R55: 10k; R55_R_0805_2012Metric_HomeMilling; MPN RC0805FR-0710KL
R56: 10k; R56_R_0805_2012Metric_HomeMilling; MPN RC0805FR-0710KL
R57: 10k; R57_R_0805_2012Metric_HomeMilling; MPN RC0805FR-0710KL
R58: 10k; R58_R_0805_2012Metric_HomeMilling; MPN RC0805FR-0710KL
R59: 10k; R59_R_0805_2012Metric_HomeMilling; MPN RC0805FR-0710KL
R60: 10k; R60_R_0805_2012Metric_HomeMilling; MPN RC0805FR-0710KL
R61: 10k; R61_R_0805_2012Metric_HomeMilling; MPN RC0805FR-0710KL
R62: 10k; R62_R_0805_2012Metric_HomeMilling; MPN RC0805FR-0710KL
R63: 10k; R63_R_0805_2012Metric_HomeMilling; MPN RC0805FR-0710KL
R64: 10k; R64_R_0805_2012Metric_HomeMilling; MPN RC0805FR-0710KL
R65: 10k; R65_R_0805_2012Metric_HomeMilling; MPN RC0805FR-0710KL
R66: 10k; R66_R_0805_2012Metric_HomeMilling; MPN RC0805FR-0710KL
R67: 4.7k; R67_R_0805_2012Metric_HomeMilling; MPN RC0805FR-074K7L
R68: 4.7k; R68_R_0805_2012Metric_HomeMilling; MPN RC0805FR-074K7L

Connections:
+3V3: J5.1, J7.1, J8.1, J9.1, J10.1, J11.1, J12.1, J13.1, J18.1, R20.1, R23.1, R26.1, R29.1, R32.1, R35.1, R38.1, R41.1, R43.1, R44.1, R45.1, R46.1, R47.1, R48.1, R49.1, R50.1, R51.1, R52.1, R53.1, R54.1, R55.1, R56.1, R57.1, R58.1, R59.1, R60.1, R61.1, R62.1, R63.1, R64.1, R65.1, R66.1, R67.1, R68.1; also elsewhere on the board
A0_ADC: C12.1, R19.2, R20.2, R21.1; also elsewhere on the board
A0_RAW: J5.2, R19.1
A1_ADC: C14.1, R22.2, R23.2, R24.1; also elsewhere on the board
A1_RAW: J7.2, R22.1
A2_ADC: C15.1, R25.2, R26.2, R27.1; also elsewhere on the board
A2_RAW: J8.2, R25.1
A3_ADC: C16.1, R28.2, R29.2, R30.1; also elsewhere on the board
A3_RAW: J9.2, R28.1
A4_ADC: C17.1, R31.2, R32.2, R33.1; also elsewhere on the board
A4_RAW: J10.2, R31.1
A5_ADC: C18.1, R34.2, R35.2, R36.1; also elsewhere on the board
A5_RAW: J11.2, R34.1
A6_ADC: C19.1, R37.2, R38.2, R39.1; also elsewhere on the board
A6_RAW: J12.2, R37.1
A7_ADC: C20.1, R40.2, R41.2, R42.1; also elsewhere on the board
A7_RAW: J13.2, R40.1
D0: J14.1, R43.2; also elsewhere on the board
D1: J14.2, R44.2; also elsewhere on the board
D2: J14.3, R45.2; also elsewhere on the board
D3: J14.4, R46.2; also elsewhere on the board
D4: J14.5, R47.2; also elsewhere on the board
D5: J14.6, R48.2; also elsewhere on the board
D6: J15.1, R49.2; also elsewhere on the board
D7: J15.2, R50.2; also elsewhere on the board
D8: J15.3, R51.2; also elsewhere on the board
D9: J15.4, R52.2; also elsewhere on the board
D10: J15.5, R53.2; also elsewhere on the board
D11: J15.6, R54.2; also elsewhere on the board
D12: J16.1, R55.2; also elsewhere on the board
D13: J16.2, R56.2; also elsewhere on the board
D14: J16.3, R57.2; also elsewhere on the board
D15: J16.4, R58.2; also elsewhere on the board
D16: J16.5, R59.2; also elsewhere on the board
D17: J16.6, R60.2; also elsewhere on the board
D18: J17.1, R61.2; also elsewhere on the board
D19: J17.2, R62.2; also elsewhere on the board
D20: J17.3, R63.2; also elsewhere on the board
D21: J17.4, R64.2; also elsewhere on the board
D22: J17.5, R65.2; also elsewhere on the board
D23: J17.6, R66.2; also elsewhere on the board
GND: C12.2, C14.2, C15.2, C16.2, C17.2, C18.2, C19.2, C20.2, J5.3, J7.3, J8.3, J9.3, J10.3, J11.3, J12.3, J13.3, J14.7, J15.7, J16.7, J17.7, J18.4, R21.2, R24.2, R27.2, R30.2, R33.2, R36.2, R39.2, R42.2; also elsewhere on the board
I2C_SCL: J18.3, R68.2; also elsewhere on the board
I2C_SDA: J18.2, R67.2; also elsewhere on the board

Notes on the sheet:
A0: 0–3.3 V input; 1 kΩ / 100 nF filter; 1 MΩ midscale bias
A1: 0–3.3 V input; 1 kΩ / 100 nF filter; 1 MΩ midscale bias
A2: 0–3.3 V input; 1 kΩ / 100 nF filter; 1 MΩ midscale bias
A3: 0–3.3 V input; 1 kΩ / 100 nF filter; 1 MΩ midscale bias
A4: 0–3.3 V input; 1 kΩ / 100 nF filter; 1 MΩ midscale bias
A5: 0–3.3 V input; 1 kΩ / 100 nF filter; 1 MΩ midscale bias
A6: 0–3.3 V input; 1 kΩ / 100 nF filter; 1 MΩ midscale bias
A7: 0–3.3 V input; 1 kΩ / 100 nF filter; 1 MΩ midscale bias
Contact inputs: close signal to GND. No external voltage.
Optional TCA9555 board: 16 active-low inputs per address; keep I2C wiring inside enclosure. No 5 V / 12 V connection. Pull-ups fitted only on base; validate 400 kHz rise time.

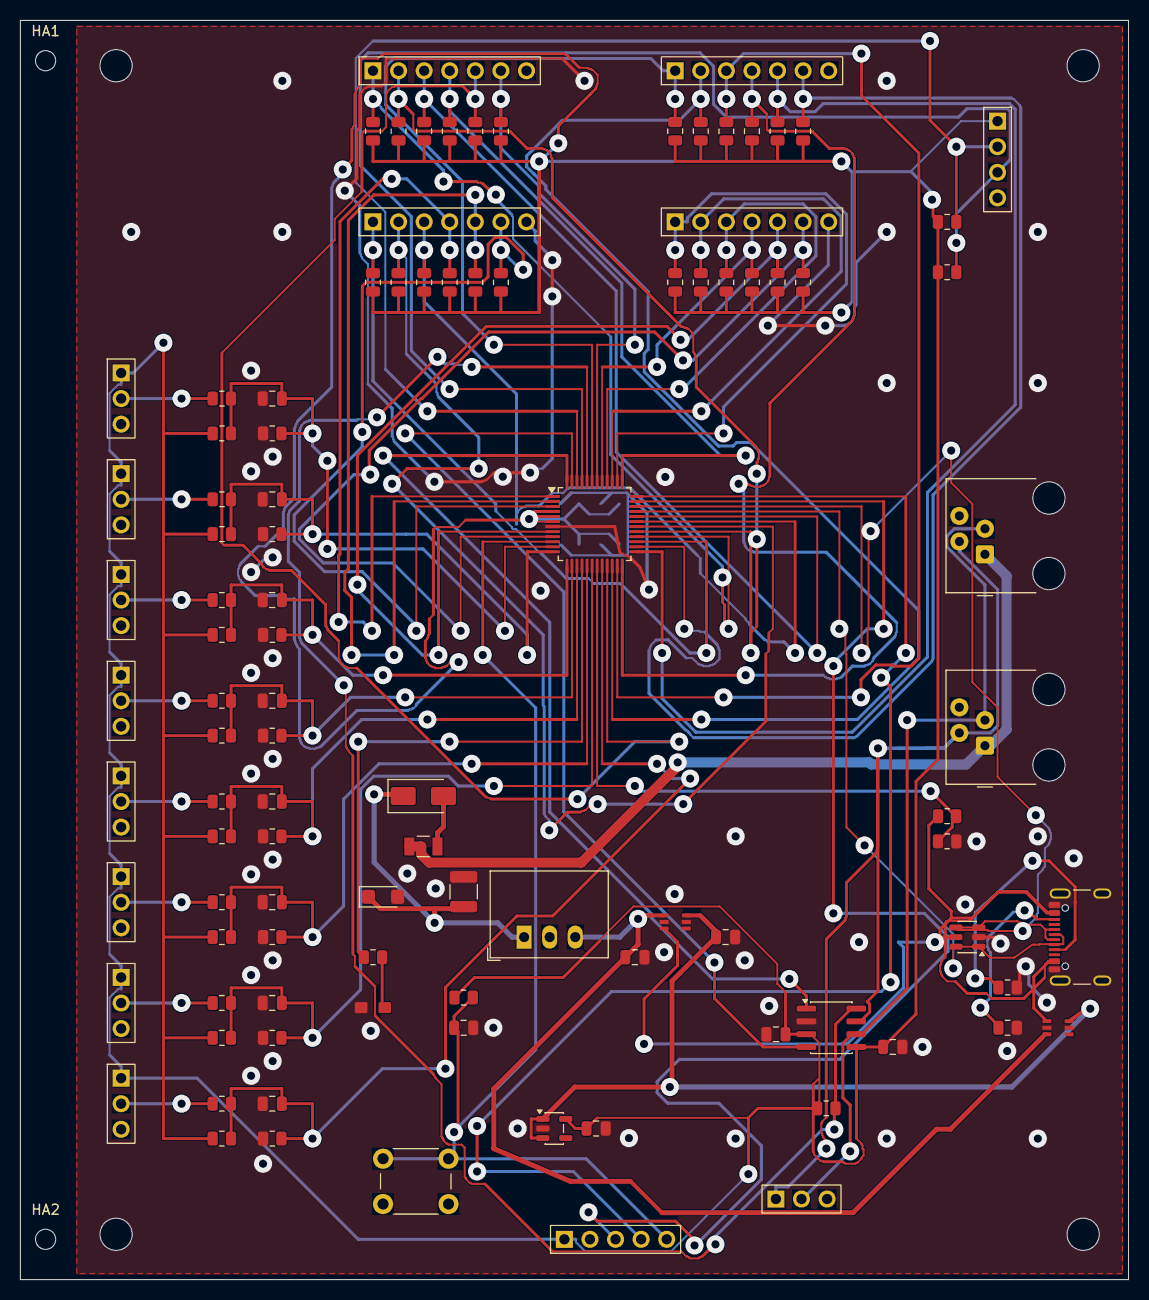
[picture p23: board starter.kicad_pcb from above]

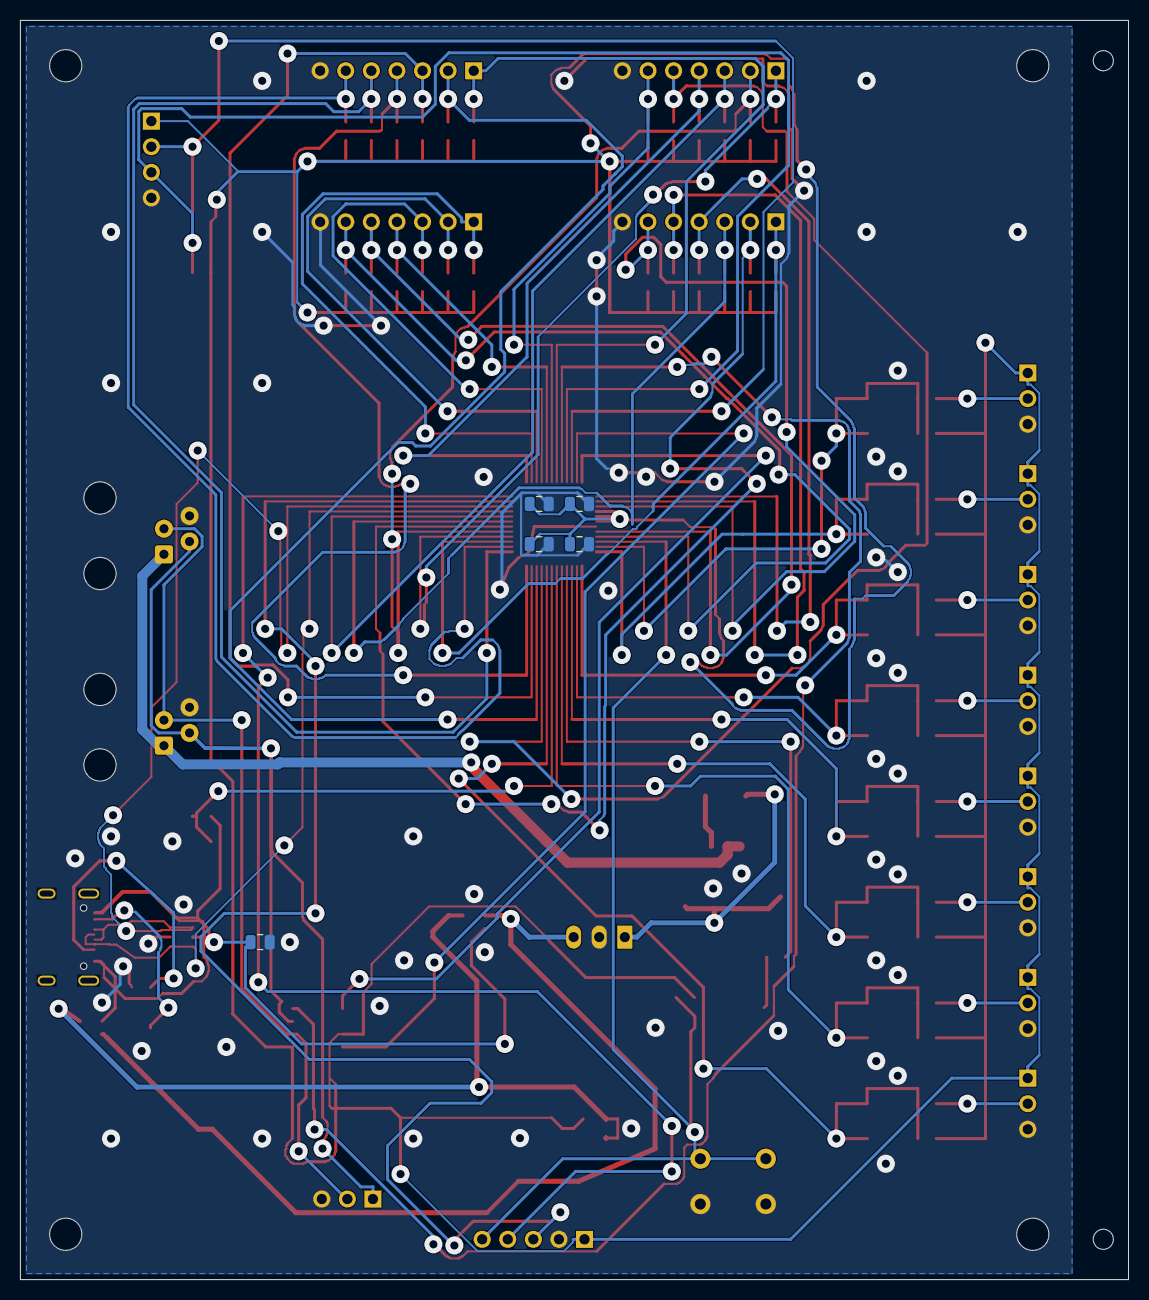
[picture p24: board starter.kicad_pcb from below]

Board: 2 copper layers, 110.0 x 125.0 mm, 113 parts (5 on the bottom side), 65 nets.

Other parts of the board:
HA1, HA2: MountingHole_2mm
