opensimgear/device-template/electronics/boards/starter/0.1.0/home-milling/coupon/milling-coupon.kicad_pcb

## KiCad design electronics/boards/starter/0.1.0/home-milling/coupon/milling-coupon.kicad_pcb (2026-10-12)

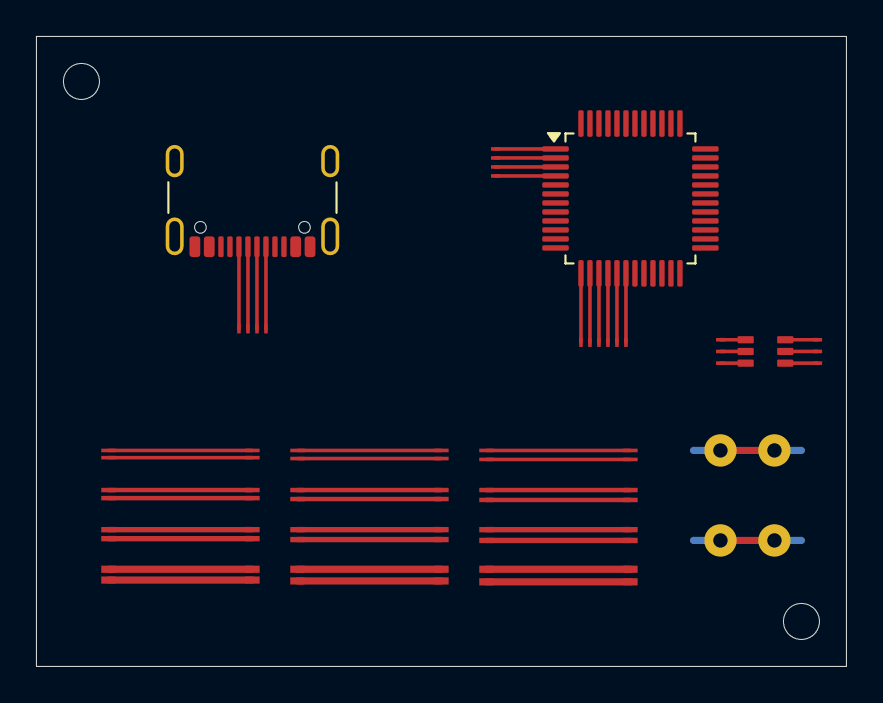
[picture p25: board milling-coupon.kicad_pcb from above]

Board: 2 copper layers, 45.0 x 35.0 mm, 33 parts (0 on the bottom side), 50 nets.

Parts:
A1, A2: 2 mm NPTH alignment; MountingHole_2mm
BACK_END_L0, BACK_END_L1: probe end
BACK_END_R0, BACK_END_R1: probe end
G1: gap 0.20
G2: gap 0.25
G3: gap 0.30
J1: USB4105-GF-A milling fit test; USB_C_Receptacle_GCT_USB4105-xx-A_16P_TopMnt_Horizontal
QFP_END_1, QFP_END_2, QFP_END_3, QFP_END_4, QFP_END_13, QFP_END_14, QFP_END_15, QFP_END_16, QFP_END_17, QFP_END_18: probe end
SC70_END_1, SC70_END_2, SC70_END_3, SC70_END_4, SC70_END_5, SC70_END_6: probe end
U1: LQFP48 milling fit test; LQFP-48_7x7mm_P0.5mm
U2: LM66100DCKR milling fit test; TI_DCK0006A_SC70-6_LM66100
USB_END_A6, USB_END_A7: probe end
USB_END_B6, USB_END_B7: probe end
WV: manual wire vias

Connections:
G200_W200_A: G1.A0L, G1.A0R
G200_W200_B: G1.B0L, G1.B0R
G200_W250_A: G1.A1L, G1.A1R
G200_W250_B: G1.B1L, G1.B1R
G200_W300_A: G1.A2L, G1.A2R
G200_W300_B: G1.B2L, G1.B2R
G200_W400_A: G1.A3L, G1.A3R
G200_W400_B: G1.B3L, G1.B3R
G250_W200_A: G2.A0L, G2.A0R
G250_W200_B: G2.B0L, G2.B0R
G250_W250_A: G2.A1L, G2.A1R
G250_W250_B: G2.B1L, G2.B1R
G250_W300_A: G2.A2L, G2.A2R
G250_W300_B: G2.B2L, G2.B2R
G250_W400_A: G2.A3L, G2.A3R
G250_W400_B: G2.B3L, G2.B3R
G300_W200_A: G3.A0L, G3.A0R
G300_W200_B: G3.B0L, G3.B0R
G300_W250_A: G3.A1L, G3.A1R
G300_W250_B: G3.B1L, G3.B1R
G300_W300_A: G3.A2L, G3.A2R
G300_W300_B: G3.B2L, G3.B2R
G300_W400_A: G3.A3L, G3.A3R
G300_W400_B: G3.B3L, G3.B3R
MANUAL_WIRE_1: BACK_END_L0.1, BACK_END_R0.1, WV.1, WV.2
MANUAL_WIRE_2: BACK_END_L1.1, BACK_END_R1.1, WV.3, WV.4
QFP_PAD_1: QFP_END_1.1, U1.1
QFP_PAD_2: QFP_END_2.1, U1.2
QFP_PAD_3: QFP_END_3.1, U1.3
QFP_PAD_4: QFP_END_4.1, U1.4
QFP_PAD_13: QFP_END_13.1, U1.13
QFP_PAD_14: QFP_END_14.1, U1.14
QFP_PAD_15: QFP_END_15.1, U1.15
QFP_PAD_16: QFP_END_16.1, U1.16
QFP_PAD_17: QFP_END_17.1, U1.17
QFP_PAD_18: QFP_END_18.1, U1.18
SC70_PAD_1: SC70_END_1.1, U2.1
SC70_PAD_2: SC70_END_2.1, U2.2
SC70_PAD_3: SC70_END_3.1, U2.3
SC70_PAD_4: SC70_END_4.1, U2.4
SC70_PAD_5: SC70_END_5.1, U2.5
SC70_PAD_6: SC70_END_6.1, U2.6
USB_CONTACT_A1: J1.A1, J1.B12
USB_CONTACT_A4: J1.A4, J1.B9
USB_CONTACT_A6: J1.A6, USB_END_A6.1
USB_CONTACT_A7: J1.A7, USB_END_A7.1
USB_CONTACT_A9: J1.A9, J1.B4
USB_CONTACT_A12: J1.A12, J1.B1
USB_CONTACT_B6: J1.B6, USB_END_B6.1
USB_CONTACT_B7: J1.B7, USB_END_B7.1
