opensimgear/device-template/firmware/include/profile.h

#pragma once
#include "runtime_config.h"
const osg_profile_t *device_profile(void);
/* Called before USB enumeration. Invalid profiles fail before attachment. */
bool device_profile_prepare(void);
bool device_profile_load(const osg_journal_io_t *);
osg_runtime_config_t *device_runtime_config(void);
const uint8_t *device_report_descriptor(size_t *length);
const osg_profile_layout_t *device_report_layout(void);
