opensimgear/device-template/firmware/boards/starter_g0b1cb_v0_1_0/can_transport.c

#include "board.h"
#include "stm32g0xx_hal.h"
#include "tusb.h"
#include <string.h>

#define TX_QUEUE_CAPACITY 32U
#define TX_TIMEOUT_MS 20U
#define TX_RETRY_MS 20U
#define CAN_RECOVERY_MS 1000U
static FDCAN_HandleTypeDef can;
static board_can_frame_t tx_queue[TX_QUEUE_CAPACITY];
static uint8_t tx_head, tx_count, tx_attempts;
static uint32_t tx_buffer, tx_started, tx_abort_started, tx_retry_at, recovery_at;
static bool tx_inflight, tx_aborting, tx_expired, recovering;
static board_can_diagnostics_t diagnostics;
static const uint8_t dlc_sizes[16] = {0,1,2,3,4,5,6,7,8,12,16,20,24,32,48,64};

static bool can_start(void) {
    can.Instance=FDCAN1;
    can.Init.ClockDivider=FDCAN_CLOCK_DIV1;
    can.Init.FrameFormat=FDCAN_FRAME_FD_BRS;
    can.Init.Mode=FDCAN_MODE_NORMAL;
    /* Application retries are bounded; an absent bus peer cannot occupy a
     * controller mailbox indefinitely. */
    can.Init.AutoRetransmission=DISABLE;
    can.Init.TransmitPause=DISABLE;
    can.Init.ProtocolException=DISABLE;
    /* 64 MHz PCLK: 500 kbit/s arbitration, 2 Mbit/s data; 87.5% sample point. */
    can.Init.NominalPrescaler=8; can.Init.NominalSyncJumpWidth=2;
    can.Init.NominalTimeSeg1=13; can.Init.NominalTimeSeg2=2;
    can.Init.DataPrescaler=2; can.Init.DataSyncJumpWidth=2;
    can.Init.DataTimeSeg1=13; can.Init.DataTimeSeg2=2;
    can.Init.StdFiltersNbr=0; can.Init.ExtFiltersNbr=1;
    can.Init.TxFifoQueueMode=FDCAN_TX_FIFO_OPERATION;
    if(HAL_FDCAN_Init(&can)!=HAL_OK) return false;
    /* Cyphal messages, services and automatic node-ID selection occupy the
     * extended-ID space. libcanard validates and filters their transfers. */
    FDCAN_FilterTypeDef filter={.IdType=FDCAN_EXTENDED_ID,.FilterIndex=0,
        .FilterType=FDCAN_FILTER_MASK,.FilterConfig=FDCAN_FILTER_TO_RXFIFO0,
        .FilterID1=0,.FilterID2=0};
    if(HAL_FDCAN_ConfigFilter(&can,&filter)!=HAL_OK ||
       HAL_FDCAN_ConfigGlobalFilter(&can,FDCAN_REJECT,FDCAN_REJECT,
           FDCAN_REJECT_REMOTE,FDCAN_REJECT_REMOTE)!=HAL_OK ||
       HAL_FDCAN_ConfigTxDelayCompensation(&can,28,0)!=HAL_OK ||
       HAL_FDCAN_EnableTxDelayCompensation(&can)!=HAL_OK || HAL_FDCAN_Start(&can)!=HAL_OK) return false;
    HAL_GPIO_WritePin(GPIOB,GPIO_PIN_5,GPIO_PIN_RESET);
    return true;
}

bool board_can_receive(board_can_frame_t *frame) {
    if(!frame || recovering || !HAL_FDCAN_GetRxFifoFillLevel(&can,FDCAN_RX_FIFO0)) return false;
    FDCAN_RxHeaderTypeDef rx;
    if(HAL_FDCAN_GetRxMessage(&can,FDCAN_RX_FIFO0,&rx,frame->data)!=HAL_OK) {
        diagnostics.rx_dropped++; return false;
    }
    if(rx.IdType!=FDCAN_EXTENDED_ID || rx.RxFrameType!=FDCAN_DATA_FRAME) {
        diagnostics.rx_dropped++; return false;
    }
    frame->id=rx.Identifier; frame->size=dlc_sizes[(rx.DataLength>>16)&15U];
    frame->fd=rx.FDFormat==FDCAN_FD_CAN; frame->brs=rx.BitRateSwitch==FDCAN_BRS_ON;
    frame->deadline_valid=false; frame->deadline_ms=0;
    diagnostics.rx++; return true;
}
bool board_can_enqueue(const board_can_frame_t *frame) {
    if(!frame || recovering || frame->id>0x1FFFFFFFU || !frame->size || frame->size>64 ||
       (!frame->fd && (frame->size>8 || frame->brs)) || tx_count==TX_QUEUE_CAPACITY) {
        diagnostics.tx_dropped++; return false;
    }
    uint8_t dlc=0; while(dlc<16 && dlc_sizes[dlc]<frame->size) dlc++;
    if(dlc==16 || dlc_sizes[dlc]!=frame->size) { diagnostics.tx_dropped++; return false; }
    tx_queue[(tx_head+tx_count)%TX_QUEUE_CAPACITY]=*frame;
    tx_count++; return true;
}
static void tx_pop(void) { tx_head=(uint8_t)((tx_head+1)%TX_QUEUE_CAPACITY); tx_count--; tx_attempts=0; }
static bool expired(const board_can_frame_t *frame,uint32_t now) {
    return frame->deadline_valid && (int32_t)(now-frame->deadline_ms)>=0;
}
static void tx_failed(uint32_t now) {
    diagnostics.tx_failed++;
    if(tx_attempts>=3) { diagnostics.tx_dropped++; tx_pop(); }
    tx_retry_at=now+TX_RETRY_MS;
}
static void enter_recovery(uint32_t now) {
    HAL_GPIO_WritePin(GPIOB,GPIO_PIN_5,GPIO_PIN_SET);
    (void)HAL_FDCAN_Stop(&can); recovering=true; recovery_at=now+CAN_RECOVERY_MS;
    diagnostics.tx_dropped+=tx_count; tx_head=tx_count=tx_attempts=0; tx_inflight=false;
    tx_aborting=tx_expired=false;
}
void board_can_task(uint32_t now) {
    FDCAN_ProtocolStatusTypeDef status={0};
    (void)HAL_FDCAN_GetProtocolStatus(&can,&status);
    diagnostics.bus_off=status.BusOff!=0;
    diagnostics.hal_error=HAL_FDCAN_GetError(&can);
    if(can.Instance->IR&FDCAN_FLAG_RX_FIFO0_MESSAGE_LOST) {
        diagnostics.rx_dropped++; __HAL_FDCAN_CLEAR_FLAG(&can,FDCAN_FLAG_RX_FIFO0_MESSAGE_LOST);
    }
    if(status.BusOff && !recovering) enter_recovery(now);
    if(recovering) {
        if((int32_t)(now-recovery_at)>=0) {
            (void)HAL_FDCAN_DeInit(&can);
            __HAL_RCC_FDCAN_FORCE_RESET(); __HAL_RCC_FDCAN_RELEASE_RESET();
            if(can_start()) { recovering=false; diagnostics.recoveries++; }
            else recovery_at=now+CAN_RECOVERY_MS;
        }
        return;
    }
    if(tx_inflight) {
        if(!HAL_FDCAN_IsTxBufferMessagePending(&can,tx_buffer)) {
            tx_inflight=false;
            if(tx_expired) { diagnostics.tx_dropped++; tx_pop(); tx_retry_at=now; }
            else if(can.Instance->TXBTO&tx_buffer) { diagnostics.tx++; tx_pop(); }
            else tx_failed(now);
            tx_aborting=tx_expired=false;
        } else if(tx_aborting || expired(&tx_queue[tx_head],now) || (uint32_t)(now-tx_started)>=TX_TIMEOUT_MS) {
            if(!tx_aborting) { tx_aborting=true; tx_abort_started=now; }
            tx_expired=tx_expired || expired(&tx_queue[tx_head],now);
            (void)HAL_FDCAN_AbortTxRequest(&can,tx_buffer);
            /* Wait for hardware cancellation before recycling the queue head. */
            if(!HAL_FDCAN_IsTxBufferMessagePending(&can,tx_buffer)) {
                tx_inflight=false;
                if(tx_expired) { diagnostics.tx_dropped++; tx_pop(); tx_retry_at=now; }
                else tx_failed(now);
                tx_aborting=tx_expired=false;
            } else if((uint32_t)(now-tx_abort_started)>=TX_TIMEOUT_MS) {
                diagnostics.tx_failed++; enter_recovery(now);
            }
        }
        return;
    }
    /* Bound cleanup to this fixed-size queue. Expired transfers never reach
     * a hardware mailbox, including when retry spacing delayed their turn. */
    for(unsigned n=0;n<TX_QUEUE_CAPACITY && tx_count && expired(&tx_queue[tx_head],now);n++) {
        diagnostics.tx_dropped++; tx_pop(); tx_retry_at=now;
    }
    if(!tx_count || (int32_t)(now-tx_retry_at)<0 || !HAL_FDCAN_GetTxFifoFreeLevel(&can)) return;
    const board_can_frame_t *frame=&tx_queue[tx_head];
    uint8_t dlc=0; while(dlc_sizes[dlc]<frame->size) dlc++;
    uint8_t data[64]={0}; memcpy(data,frame->data,frame->size);
    FDCAN_TxHeaderTypeDef tx={.Identifier=frame->id,.IdType=FDCAN_EXTENDED_ID,
        .TxFrameType=FDCAN_DATA_FRAME,.DataLength=(uint32_t)dlc<<16,
        .ErrorStateIndicator=FDCAN_ESI_ACTIVE,.BitRateSwitch=frame->brs?FDCAN_BRS_ON:FDCAN_BRS_OFF,
        .FDFormat=frame->fd?FDCAN_FD_CAN:FDCAN_CLASSIC_CAN,.TxEventFifoControl=FDCAN_NO_TX_EVENTS};
    tx_attempts++;
    if(HAL_FDCAN_AddMessageToTxFifoQ(&can,&tx,data)!=HAL_OK) { tx_failed(now); return; }
    tx_buffer=HAL_FDCAN_GetLatestTxFifoQRequestBuffer(&can); tx_started=now; tx_inflight=true;
    tx_aborting=tx_expired=false;
}
board_can_diagnostics_t board_can_diagnostics(void) {
    FDCAN_ErrorCountersTypeDef counters={0};
    (void)HAL_FDCAN_GetErrorCounters(&can,&counters);
    diagnostics.tx_queue=tx_count; diagnostics.rx_error=(uint8_t)counters.RxErrorCnt;
    diagnostics.tx_error=(uint8_t)counters.TxErrorCnt; diagnostics.recovering=recovering;
    return diagnostics;
}

void board_can_init(void) { __HAL_RCC_FDCAN_CLK_ENABLE(); if(!can_start()) board_fault(); }
void board_can_reset(uint32_t now) {
    if(recovering) return; /* A real bus fault retains its recovery deadline. */
    HAL_GPIO_WritePin(GPIOB,GPIO_PIN_5,GPIO_PIN_SET);
    (void)HAL_FDCAN_Stop(&can); (void)HAL_FDCAN_DeInit(&can);
    diagnostics.tx_dropped+=tx_count; tx_head=tx_count=tx_attempts=0; tx_inflight=false; tx_retry_at=now;
    tx_aborting=tx_expired=false;
    /* DeInit alone does not clear pending controller mailboxes/RX FIFO. */
    __HAL_RCC_FDCAN_FORCE_RESET(); __HAL_RCC_FDCAN_RELEASE_RESET();
    if(!can_start()) { recovering=true; recovery_at=now+CAN_RECOVERY_MS; }
}
