opensimgear/device-template/(commit log)

2026-10-11 Rename device template references and clarify starter scope
2026-10-11 Implement STM32G0B1 hello-world firmware and editable KiCad starter
    [bom.csv, starter.kicad_pcb, starter.kicad_sch]
2026-10-11 Keep KiCad session locks out of the template and normalize preview
2026-10-11 Add representative button, axis, hat, encoder and switch examples
    [bom.csv, inputs.kicad_sch, starter.kicad_pcb, starter.kicad_sch]
2026-10-11 Route STM32G0B1 starter PCB and verify copper connectivity
    [starter.kicad_pcb, starter.kicad_sch]
2026-10-12 Review compact four-layer PCB and add milling qualification coupon
    [bom.csv, inputs.kicad_sch, milling-coupon.kicad_pcb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]
2026-10-12 Add Makera two-layer prototype and unplated assembly audits
    [inputs.kicad_sch, starter.kicad_pcb, starter.kicad_sch, wire-joins.csv]
2026-10-12 Add generic Rev B input board, configurable profiles and I2C expansion
    [bom.csv, inputs.kicad_sch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]
2026-10-12 Save Rev A schematic edits and align gateway documentation
    [inputs.kicad_sch, starter.kicad_sch]
2026-10-12 chore: move CAD review source paths into research
2026-10-12 docs: update module status and historical board compatibility
2026-10-13 Add independent JSON-configured native device simulation
2026-10-13 Consolidate device PCB as pre-live version 0.1.0
    [bom.csv, inputs.kicad_sch, milling-coupon.kicad_pcb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]
2026-10-13 Fix GCC warning in native device cleanup
    [device.c]
2026-10-13 Add JLCPCB fabrication and assembly export tooling
2026-10-13 Support 32 gateway routes and pin shared USB helpers
2026-10-13 Add board and simulated LED actions with independent CAN route status
2026-10-13 Pin matching gateway action revision for integration checks
2026-10-13 Wait for active simulation settings after apply and reset
    [test.py]
2026-10-13 Capture panel events and simulate the board master-caution panel
2026-10-13 Pin matching gateway event transport in integration CI
2026-10-14 Pin matching gateway sources in panel integration CI
2026-10-14 Implement output-only devices and enforced output ownership
2026-10-14 Use matching M4 gateway for device integration CI
